bradleyeckert/chad/doc/README.md

# Feature summaries

- `crypto` SPI Flash encryption
- `debug` Debugging tools
- `forth` Differences from ANS Forth
- `interrupts` How interrupts work
- `io` I/O mapping
- `isa` Instruction Set Architecture
- `lcd` LCD module (ILI9341) simulator
- `manifesto` Ramblings of a madman
- `spif` SPI flash controller intelligent hub
