bradleyeckert/chad/utility/README.md

# Utilities

- `isp` an In-System-Programming over UART tool.
- `term` is a simple terminal using the same RS232 stack.
- `fonts` is a Unicode bitmap extraction tool for LCDs.

To Do:

Integrate `isp` into `term` to allow firmware updates without leaving the terminal.
