bradleyeckert/chad/doc/stack.png

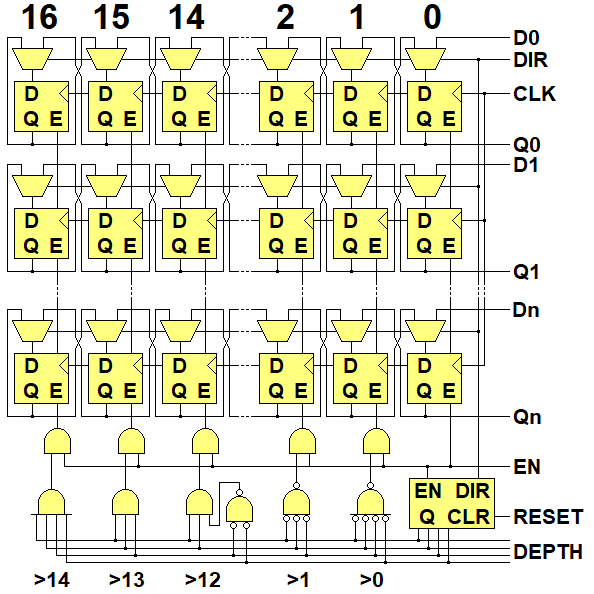
doc/stack.png
