bradleyeckert/chad/verilog/testbench/s25fl064l.v

///////////////////////////////////////////////////////////////////////////////
//  File name : s25fl064l.v
///////////////////////////////////////////////////////////////////////////////
//  Copyright (C) 2018-2019 Free Model Foundry; http://www.FreeModelFoundry.com
//
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
//  MODIFICATION HISTORY :
//
//  version: |   author:     |  mod date:  |  changes made:
//    V1.0      B.Barac        18 Feb 14     Initial version
//    V1.1      M.Dinic        18 Jun 08     Bug 18 fixed -
//                                           added !CSNeg condition for
//                                           two model instances
//    V1.2      B.Barac        19 Feb 06     SFDP update
//              B.Eckert       12 Oct 20     tdevice_PU = 3 ns
//
///////////////////////////////////////////////////////////////////////////////
//  PART DESCRIPTION:
//
//  Library:    FLASH
//  Technology: FLASH MEMORY
//  Part:       S25FL064L
//
//  Description: 64 Megabit Serial Flash Memory
//
//////////////////////////////////////////////////////////////////////////////
//  Comments :
//      For correct simulation, simulator resolution should be set to 1 ps
//
//////////////////////////////////////////////////////////////////////////////
//  Known Bugs:
//
//////////////////////////////////////////////////////////////////////////////

//////////////////////////////////////////////////////////////////////////////
// MODULE DECLARATION                                                       //
//////////////////////////////////////////////////////////////////////////////
`timescale 1 ps/1 ps

module s25fl064l
    (
        // Data Inputs/Outputs
        SI     ,
        SO     ,
        SCK    ,
        CSNeg  ,
        RESETNeg,
        WPNeg  ,
        IO3_RESETNeg
    );

///////////////////////////////////////////////////////////////////////////////
// Port / Part Pin Declarations
///////////////////////////////////////////////////////////////////////////////

    inout   SI            ;
    inout   SO            ;

    input   SCK           ;
    input   CSNeg         ;
    input   RESETNeg      ;
    inout   WPNeg         ;
    inout   IO3_RESETNeg  ;

    // interconnect path delay signals
    wire   SCK_ipd        ;
    wire   SI_ipd         ;
    wire   SO_ipd         ;
    wire   CSNeg_ipd      ;
    wire   RESETNeg_ipd   ;
    wire   WPNeg_ipd      ;
    wire   IO3_RESETNeg_ipd   ;

    wire SI_in            ;
    assign SI_in = SI_ipd ;

    wire SI_out           ;
    assign SI_out = SI    ;

    wire SO_in            ;
    assign SO_in = SO_ipd ;

    wire SO_out           ;
    assign SO_out = SO    ;

    wire   WPNeg_in                 ;
    //Internal pull-up
    assign WPNeg_in = (WPNeg_ipd === 1'bx) ? 1'b1 : WPNeg_ipd;

    wire   WPNeg_out                ;
    assign WPNeg_out = WPNeg        ;

    wire   RESETNeg_in              ;
    //Internal pull-up
    assign RESETNeg_in = (RESETNeg_ipd===1'bx) ? 1'b1:RESETNeg_ipd;

    wire   RESETNeg_out             ;
    assign RESETNeg_out = RESETNeg  ;

    wire   IO3_RESETNeg_in              ;
    //Internal pull-up
    assign IO3_RESETNeg_in=(IO3_RESETNeg_ipd===1'bx) ? 1'b1:IO3_RESETNeg_ipd;

    wire   IO3_RESETNeg_out             ;
    assign IO3_RESETNeg_out = IO3_RESETNeg  ;

    // internal delays
    reg ERSSUSP_in = 1'b0 ;
    reg ERSSUSP_out = 1'b0 ;
    reg PRGSUSP_in = 1'b0  ;
    reg PRGSUSP_out = 1'b0 ;
    reg PASSULCK_in = 1'b0 ;
    reg PASSULCK_out = 1'b0;
    reg SFT_RST_in = 1'b0;
    reg SFT_RST_out = 1'b1;
    reg HW_RST_in   = 1'b0;
    reg HW_RST_out  = 1'b1;
    reg DPD_in = 1'b0;
    reg DPD_out = 1'b0;
    reg RES_in = 1'b0;
    reg RES_out = 1'b0;
    reg QEN_in = 1'b0;
    reg QEN_out = 1'b0;
    reg QEXN_in = 1'b0;
    reg QEXN_out = 1'b0;

    reg rising_edge_CSNeg_ipd  = 1'b0;
    reg rising_edge_CSNeg_d    = 1'b0;
    reg falling_edge_CSNeg_ipd = 1'b0;
    reg rising_edge_SCK_ipd    = 1'b0;
    reg rising_edge_SCK_D      = 1'b0;
    reg falling_edge_SCK_D     = 1'b0;
    reg falling_edge_SCK_ipd   = 1'b0;
    reg falling_edge_RST       = 1'b0;
    reg rising_edge_PSTART     = 1'b0;
    reg rising_edge_PDONE      = 1'b0;
    reg rising_edge_ESTART     = 1'b0;
    reg rising_edge_EDONE      = 1'b0;
    reg rising_edge_WSTART_NV  = 1'b0;
    reg rising_edge_WSTART_V   = 1'b0;
    reg rising_edge_WDONE      = 1'b0;

    reg rising_edge_RES_out    = 1'b0;
    reg falling_edge_RES_in    = 1'b0;
    reg rising_edge_PRGSUSP_out;
    reg rising_edge_ERSSUSP_out;
    reg rising_edge_QEN_out;
    reg rising_edge_QEXN_out;
    reg rising_edge_PASSULCK_out;
    reg rising_edge_SFT_RST_out;
    reg rising_edge_HW_RST_out;
    reg rising_edge_reseted  = 1'b0;
    reg rising_edge_PoweredUp = 1'b0;

    reg SOut_zd        = 1'bZ;
    reg SIOut_zd       = 1'bZ;
    reg WPNegOut_zd    = 1'bZ;
    reg IO3_RESETNegOut_zd = 1'bZ;

    parameter UserPreload       = 1;
    parameter mem_file_name     = "none";//"s25fl064l.mem";
    parameter secr_file_name    = "s25fl064lSECR.mem";//"none";

    parameter TimingModel       = "DefaultTimingModel";

    parameter  PartID           = "s25fl064l";
    parameter  MaxData          = 255;
    parameter  MemSize          = 24'h7FFFFF;
    parameter  PageSize         = 8'hFF;
    parameter  SecRegSize       = 8'hFF;
    parameter  SecSize          = 12'hFFF;
    parameter  HalfBlockSize    = 15'h7FFF;
    parameter  BlockSize        = 16'hFFFF;
    parameter  SecNum           = 12'h7FF;
    parameter  BlockNum         = 7'h7F;
    parameter  HalfBlockNum     = 8'hFF;
    parameter  SecRegNum        = 3;

    parameter  PageNum          = 19'h7FFF;
    parameter  AddrRANGE        = 27'h7FFFFF;

    parameter  SECRLoAddr       = 12'h000;
    parameter  SECRHiAddr       = 12'h3FF;

    parameter  SFDPLoAddr       = 16'h0000;
    parameter  SFDPHiAddr       = 16'h5FF;
    parameter  SFDPLength       = 16'h5FF;

    parameter  IDCFILength      = 16'h115;

    parameter  ManufIDDeviceID  = 24'h176001;
    parameter  DeviceID         = 16'h6017;
    parameter  UID              = 64'b0;

    reg SECURE_OPN = 1'b0;
    reg QIO_ONLY_OPN = 1'b0;
    reg QPI_ONLY_OPN = 1'b0;

    reg [24*8-1:0] tmp_timing;//stores copy of TimingModel
    reg [7:0] tmp_char1; //Define General Market or Secure Device
    integer found = 1'b0;

    // If speedsimulation is needed uncomment following line

//        `define SPEEDSIM;

    // powerup
    reg PoweredUp;

    // FSM states
    parameter STANDBY             = 7'd0;
    parameter RESET_STATE         = 7'd1;
    parameter RD_ADDR             = 7'd2;
    parameter FAST_RD_ADDR        = 7'd3;
    parameter DUALO_RD_ADDR       = 7'd4;
    parameter DUALIO_RD_ADDR      = 7'd5;
    parameter QUADO_RD_ADDR       = 7'd6;
    parameter QUADIO_RD_ADDR      = 7'd7;
    parameter DDRQUADIO_RD_ADDR   = 7'd8;
    parameter DLPRD_DUMMY         = 7'd9;
    parameter IRPRD_DUMMY         = 7'd10;
    parameter IBLRD_ADDR          = 7'd11;
    parameter SFT_RST_EN          = 7'd12;
    parameter SECRR_ADDR          = 7'd13;
    parameter PASSRD_DUMMY        = 7'd14;
    parameter PRRD_DUMMY          = 7'd15;
    parameter RDID_DATA_OUTPUT    = 7'd16;
    parameter RDQID_DATA_OUTPUT   = 7'd17;
    parameter RUID_DUMMY          = 7'd18;
    parameter RSFDP_ADDR          = 7'd19;
    parameter SET_BURST_DATA_INPUT = 7'd20;
    parameter RDSR1_DATA_OUTPUT    = 7'd21;
    parameter RDSR2_DATA_OUTPUT    = 7'd22;
    parameter RDCR1_DATA_OUTPUT    = 7'd23;
    parameter RDCR2_DATA_OUTPUT    = 7'd24;
    parameter RDCR3_DATA_OUTPUT    = 7'd25;
    parameter RDAR_ADDR            = 7'd26;
    parameter DPD                  = 7'd27;
    parameter RDP_DUMMY            = 7'd28;
    parameter PGM_ADDR             = 7'd29;
    parameter SECT_ERS_ADDR        = 7'd30;
    parameter HALF_BLOCK_ERS_ADDR  = 7'd31;
    parameter BLOCK_ERS_ADDR       = 7'd32;
    parameter CHIP_ERS             = 7'd33;
    parameter IBL_LOCK             = 7'd34;
    parameter IRP_PGM_DATA_INPUT   = 7'd35;
    parameter WRR_DATA_INPUT       = 7'd36;
    parameter WRAR_ADDR            = 7'd37;
    parameter PASSP_DATA_INPUT     = 7'd38;
    parameter SEC_REG_PGM_ADDR     = 7'd39;
    parameter SEC_REG_ERS_ADDR     = 7'd40;
    parameter PASSU_DATA_INPUT     = 7'd41;
    parameter IBL_UNLOCK           = 7'd42;
    parameter SET_PNTR_PROT_ADDR   = 7'd43;
    parameter PGM_NV_DLR_DATA      = 7'd44;
    parameter DLRV_WRITE_DATA      = 7'd45;
    parameter RD_DATA              = 7'd46;
    parameter FAST_RD_DUMMY        = 7'd47;
    parameter FAST_RD_DATA         = 7'd48;
    parameter DUALO_RD_DUMMY       = 7'd49;
    parameter DUALO_RD_DATA        = 7'd50;
    parameter QUADO_RD_DUMMY       = 7'd51;
    parameter QUADO_RD_DATA        = 7'd52;
    parameter DUALIO_RD_DUMMY      = 7'd53;
    parameter DUALIO_RD_MODE       = 7'd54;
    parameter DUALIO_RD_DATA       = 7'd55;
    parameter QUADIO_RD_DUMMY      = 7'd56;
    parameter QUADIO_RD_MODE       = 7'd57;
    parameter QUADIO_RD_DATA       = 7'd58;
    parameter DDRQUADIO_RD_DUMMY   = 7'd59;
    parameter DDRQUADIO_RD_MODE    = 7'd60;
    parameter DDRQUADIO_RD_DATA    = 7'd61;
    parameter RDAR_DUMMY           = 7'd62;
    parameter RDAR_DATA_OUTPUT     = 7'd63;
    parameter PGM_DATAIN           = 7'd64;
    parameter PGM                  = 7'd65;
    parameter PGMSUS               = 7'd66;
    parameter SECT_ERS             = 7'd67;
    parameter HALF_BLOCK_ERS       = 7'd68;
    parameter BLOCK_ERS            = 7'd69;
    parameter ERSSUS               = 7'd70;
    parameter SEC_REG_PGM_DATAIN   = 7'd71;
    parameter PGM_SEC_REG          = 7'd72;
    parameter SECT_ERS_SEC_REG     = 7'd73;
    parameter DLPRD_DATA_OUTPUT    = 7'd74;
    parameter IRPRD_DATA_OUTPUT    = 7'd75;
    parameter IBLRD_DATA_OUTPUT    = 7'd76;
    parameter SECRR_DUMMY          = 7'd77;
    parameter SECRR_DATA_OUTPUT    = 7'd78;
    parameter PASSRD_DATA_OUTPUT   = 7'd79;
    parameter PRRD_DATA_OUTPUT     = 7'd80;
    parameter RUID_DATA_OUTPUT     = 7'd81;
    parameter RSFDP_DUMMY          = 7'd82;
    parameter RSFDP_DATA_OUTPUT    = 7'd83;
    parameter RDP_DATA_OUTPUT      = 7'd84;
    parameter IRP_PGM              = 7'd85;
    parameter WRR_NV               = 7'd86;
    parameter WRR_V                = 7'd87;
    parameter WRAR_DATA_INPUT      = 7'd88;
    parameter WRAR_NV              = 7'd89;
    parameter WRAR_V               = 7'd90;
    parameter PGM_NV_DLR           = 7'd91;
    parameter SET_PNTR_PROT        = 7'd92;
    parameter PASS_PGM             = 7'd93;
    parameter PASS_ULCK            = 7'd94;

    reg [6:0] current_state = STANDBY;
    reg [6:0] next_state = STANDBY;

    // Instruction type
    parameter NONE            = 7'd0;
    parameter READ            = 7'd1;
    parameter READ4           = 7'd2;
    parameter FAST_READ       = 7'd3;
    parameter FAST_READ4      = 7'd4;
    parameter DOR             = 7'd5;
    parameter DOR4            = 7'd6;
    parameter DIOR            = 7'd7;
    parameter DIOR4           = 7'd8;
    parameter QOR             = 7'd9;
    parameter QOR4            = 7'd10;
    parameter QIOR            = 7'd11;
    parameter QIOR4           = 7'd12;
    parameter DDRQIOR         = 7'd13;
    parameter DDRQIOR4        = 7'd14;
    parameter DLPRD           = 7'd15;
    parameter IRPRD           = 7'd16;
    parameter IBLRD           = 7'd17;
    parameter IBLRD4          = 7'd18;
    parameter RSTEN           = 7'd19;
    parameter SECRR           = 7'd20;
    parameter PASSRD          = 7'd21;
    parameter PRRD            = 7'd22;
    parameter RDID            = 7'd23;
    parameter RDQID           = 7'd24;
    parameter RUID            = 7'd25;
    parameter RSFDP           = 7'd26;
    parameter SET_BURST       = 7'd27;
    parameter BEN4            = 7'd28;
    parameter BEX4            = 7'd29;
    parameter QPIEN           = 7'd30;
    parameter QPIEX           = 7'd31;
    parameter RDSR1           = 7'd32;
    parameter RDSR2           = 7'd33;
    parameter RDCR1           = 7'd34;
    parameter RDCR2           = 7'd35;
    parameter RDCR3           = 7'd36;
    parameter RDAR            = 7'd37;
    parameter DEEP_PD         = 7'd38;
    parameter RES             = 7'd39;
    parameter WREN            = 7'd40;
    parameter WRENV           = 7'd41;
    parameter WRDI            = 7'd42;
    parameter CLSR            = 7'd43;
    parameter PP              = 7'd44;
    parameter PP4             = 7'd45;
    parameter QPP             = 7'd46;
    parameter QPP4            = 7'd47;
    parameter SE              = 7'd48;
    parameter SE4             = 7'd49;
    parameter HBE             = 7'd50;
    parameter HBE4            = 7'd51;
    parameter BE              = 7'd52;
    parameter BE4             = 7'd53;
    parameter CE              = 7'd54;
    parameter IBL             = 7'd55;
    parameter IBL4            = 7'd56;
    parameter IRPP            = 7'd57;
    parameter WRR             = 7'd58;
    parameter WRAR            = 7'd59;
    parameter PASSP           = 7'd60;
    parameter SECRP           = 7'd61;
    parameter SECRE           = 7'd62;
    parameter PASSU           = 7'd63;
    parameter PRL             = 7'd64;
    parameter IBUL            = 7'd65;
    parameter IBUL4           = 7'd66;
    parameter GBL             = 7'd67;
    parameter GBUL            = 7'd68;
    parameter SPRP            = 7'd69;
    parameter SPRP4           = 7'd70;
    parameter PDLRNV          = 7'd71;
    parameter WDLRV           = 7'd72;
    parameter EPS             = 7'd73;
    parameter EPR             = 7'd74;
    parameter RSTCMD          = 7'd75;

    // Command Register
    reg [7:0] Instruct;
    reg [7:0] Instruct_tmp;
    reg [7:0] mode_byte;

    reg reseted;
    reg RST = 1;

    reg WREN_V;
    integer opcode_cnt = 0;
    reg [7:0] opcode;
    reg [31:0] Address;
    reg [31:0] Address_wrar;
    integer sec;
    integer blk;
    integer pgm_page;
    integer sec_region;
    integer addr_cnt = 0;
    integer Latency_code;
    integer WrapLength;
    integer dummy_cnt = 0;
    integer mode_cnt = 0;
    integer read_cnt  = 0;
    integer byte_cnt  = 0;
    reg[7:0] data_out;

    integer data_cnt   = 0;
    integer bit_cnt    = 0;
    reg[7:0] Data_in[0:PageSize];
    reg [7:0] Byte_slv = {8{1'b1}};

    integer WByte[0:255];
    integer WData [0:255];

    integer Addr;
    integer Addr_tmp;

    reg [SecNum:0] Sec_Prot = {(SecNum+1){1'b0}};
    reg [HalfBlockNum:0] HalfBlock_Prot = {(HalfBlockNum+1){1'b0}};
    reg [BlockNum:0] Block_Prot = {(BlockNum+1){1'b0}};

    reg [SecNum:0] Legacy_Sec_Prot  = {(SecNum+1){1'b0}};
    reg [SecNum:0] IBL_Sec_Prot  = {(SecNum+1){1'b0}};
    reg [SecNum:0] PRP_Sec_Prot  = {(SecNum+1){1'b0}};

    reg DPD_ACT;
    reg DLP_ACT;
    reg PGM_ACT = 0;
    reg PGM_SEC_REG_ACT = 0;
    reg SECT_ERS_ACT = 0;
    reg HALF_BLOCK_ERS_ACT = 0;
    reg BLOCK_ERS_ACT = 0;
    reg CHIP_ERS_ACT = 0;
    reg SECT_ERS_SEC_REG_ACT = 0;
    reg WRR_NV_ACT = 0;
    reg WRAR_NV_ACT = 0;
    reg IRP_ACT = 0;
    reg DLRNV_ACT = 0;
    reg SET_PNTR_PROT_ACT = 0;
    reg PASS_PGM_ACT = 0;

    reg DLRNV_programmed = 0;

    time CLK_PER;
    time LAST_CLK;

    // FSM control signals
    reg PDONE     ;
    reg PSTART    ;
    reg PGSUSP    ;
    reg PGRES     ;

    reg RES_TO_SUSP_TIME;

    reg WDONE     ;
    reg WSTART_NV ;
    reg WSTART_V  ;

    reg EDONE     ;
    reg ESTART    ;
    reg ESUSP     ;
    reg ERES      ;

    reg WL6       ;
    reg WL5       ;
    reg WL4       ;

    // SFDP array
    integer SFDP_array[SFDPLoAddr:SFDPHiAddr];
    // Security Region array
    integer SECRMem[SECRLoAddr:SECRHiAddr];
    // Flash Memory Array
    integer Mem[0:AddrRANGE];

    //-----------------------------------------
    //  Registers
    //-----------------------------------------

    reg [7:0] SR1NV    = 8'h00;
    reg [7:0] SR1V     = 8'h00;
    reg [7:0] SR1_in   = 8'h00;

    wire SEC;
    assign SEC = SR1V[6];
    wire TBPROT;
    assign TBPROT = SR1V[5];
    wire BP2;
    assign BP2 = SR1V[4];
    wire BP1;
    assign BP1 = SR1V[3];
    wire BP0;
    assign BP0 = SR1V[2];
    wire WEL;
    assign WEL = SR1V[1];
    wire WIP;
    assign WIP = SR1V[0];

    reg [7:0] SR2V     = 8'h00;

    reg [7:0] CR1NV    = 8'h00;
    reg [7:0] CR1V     = 8'h00;
    reg [7:0] CR1_in   = 8'h00;

    wire CMP;
    assign CMP = CR1V[6];
    wire LB3;
    assign LB3 = CR1V[5];
    wire LB2;
    assign LB2 = CR1V[4];
    wire LB1;
    assign LB1 = CR1V[3];
    wire LB0;
    assign LB0 = CR1V[2];
    wire QUAD;
    assign QUAD = CR1V[1];
    wire srp1;
    assign srp1 = CR1V[0];

    reg [7:0] CR2NV    = 8'h60;
    reg [7:0] CR2V     = 8'h60;
    reg [7:0] CR2_in   = 8'h00;

    wire QPI;
    assign QPI = CR2V[3];
    wire IO3R;
    assign IO3R = CR2V[7];
    wire WPS;
    assign WPS = CR2V[2];

    reg [7:0] CR3NV    = 8'h78;
    reg [7:0] CR3V     = 8'h78;
    reg [7:0] CR3_in   = 8'h00;

    reg [31:0] WRR_in  = 32'd0;
    reg [7:0] WRAR_in  = 8'd0;

    reg[15:0] IRP    = 16'hFFFD;
    reg[15:0] IRP_in = 16'hFFFD;

    reg[63:0] Password_reg     = 64'hFFFFFFFFFFFFFFFF;
    reg[63:0] Password_reg_in  = 64'hFFFFFFFFFFFFFFFF;
    reg[63:0] Password_regU_in = 64'h0;

    // Protection Register
    reg[7:0] PR              = 8'h41;
    reg[7:0] PR_in           = 8'h41;

    wire   NVLOCK;
    assign NVLOCK     = PR[0];
    wire   SECRRP;
    assign SECRRP     = PR[6];

    // Pointer Region Protect Register
    reg[31:0] PRPR    = 32'hFFFFFFFF;
    reg[31:0] PRPR_in  = 32'hFFFFFFFF;

    // Individual Block Lock Access Register
    reg[7:0] IBLAR             = 8'h00;

    // DLP registers
    reg[7:0] DLRV          = 8'h00;
    reg[7:0] DLRNV         = 8'h00;
    reg[7:0] DLRV_in       = 8'h00;
    reg[7:0] DLRNV_in      = 8'h00;

    reg [7:0] RDAR_reg    = 8'h00;

    integer SectorErase = 0;
    integer HalfBlockErase = 0;
    integer BlockErase = 0;

    // timing check violation
    reg Viol = 1'b0;

    integer AddrLOW;
    integer AddrHIGH;

    reg[7:0]  old_bit, new_bit;
    integer old_int, new_int;
    integer wr_cnt;
    integer cnt;

    reg normal_rd = 0;
    reg fast_rd = 1;
    reg ddr_rd = 0;
    reg reg_rd = 0;

    reg frst_addr_nibb;

    reg  glitch = 1'b0;
    reg  DataDriveOut_SO = 1'bZ ;
    reg  DataDriveOut_SI = 1'bZ ;
    reg  DataDriveOut_IO3_RESET = 1'bZ ;
    reg  DataDriveOut_WP = 1'bZ ;

///////////////////////////////////////////////////////////////////////////////
//Interconnect Path Delay Section
///////////////////////////////////////////////////////////////////////////////
 buf   (SCK_ipd, SCK);
 buf   (SI_ipd, SI);
 buf   (SO_ipd, SO);
 buf   (CSNeg_ipd, CSNeg);
 buf   (WPNeg_ipd, WPNeg);
 buf   (IO3_RESETNeg_ipd, IO3_RESETNeg);

///////////////////////////////////////////////////////////////////////////////
// Propagation  delay Section
///////////////////////////////////////////////////////////////////////////////
    nmos   (SI,       SIOut_zd       , 1);
    nmos   (SO,       SOut_zd        , 1);
    nmos   (IO3_RESETNeg, IO3_RESETNegOut_zd , 1);
    nmos   (WPNeg,    WPNegOut_zd    , 1);

    // Needed for TimingChecks
    // VHDL CheckEnable Equivalent

    wire io3_rst;
    assign io3_rst = IO3R && ((~QUAD & ~QPI) | CSNeg_ipd);

    wire ddr;
    assign ddr = (Instruct==DDRQIOR) | (Instruct==DDRQIOR4);

    wire RST_QUAD;
    assign RST_QUAD = IO3R & (QUAD | QPI);

    wire datain;
    assign datain = SOut_zd === 1'bz;

    wire datain_ddr;
    assign datain_ddr = datain & ddr;

    wire srp0;
    assign srp0 = SR1V[7];

    wire WrProt;
    assign WrProt = SR1V[7] & ~CR1V[1] & ~CR2V[3];

    wire rd_normal;
    wire rd_fast;
    wire rd_ddr;
    wire rd_reg;

    assign rd_normal = normal_rd;
    assign rd_fast = fast_rd;
    assign rd_ddr = ddr_rd;
    assign rd_reg = reg_rd;

specify
        // tipd delays: interconnect path delays , mapped to input port delays.
        // In Verilog is not necessary to declare any tipd_ delay variables,
        // they can be taken from SDF file
        // With all the other delays real delays would be taken from SDF file

    // tpd delays
    specparam        tpd_SCK_SO      = 1; // tV
    specparam        tpd_CSNeg_SO_RST_QUAD_EQ_1 = 1; // tDIS
    specparam        tpd_CSNeg_SO_RST_QUAD_EQ_0 = 1; // tDIS

    //tsetup values: setup times
    specparam        tsetup_CSNeg_SCK        = 1;   // tCSS edge /
    specparam        tsetup_SI_SCK           = 1;   // tSU  edge /
    specparam        tsetup_WPNeg_CSNeg      = 1;   // tWPS edge \

    //thold values: hold times
    specparam        thold_CSNeg_SCK         = 1;   // tCSH edge /
    specparam        thold_SI_SCK            = 1;   // tHD  edge /
    specparam        thold_WPNeg_CSNeg       = 1;   // tWPH edge /
    specparam        thold_CSNeg_RESETNeg    = 1;   // tRH  edge /
    specparam        thold_CSNeg_IO3_RESETNeg= 1;   // tRH  edge /

    // tpw values: pulse width
    specparam        tpw_SCK_normal  = 1;
    specparam        tpw_SCK_fast    = 1;
    specparam        tpw_SCK_ddr     = 1;
    specparam        tpw_SCK_reg     = 1;
    specparam        tpw_CSNeg       = 1;   // tCS
    specparam        tpw_RESETNeg    = 1;   // tRP
    specparam        tpw_IO3_RESETNeg= 1;   // tRP

    // tperiod min (calculated as 1/max freq)
    specparam        tperiod_SCK_normal   = 1;   // 50 MHz
    specparam        tperiod_SCK_fast     = 1;   //108 MHz
    specparam        tperiod_SCK_ddr      = 1;   // 54 MHz
    specparam        tperiod_SCK_reg      = 1;   // 108 MHz

    `ifdef SPEEDSIM
        // WRR Cycle Time
        specparam        tdevice_WRR               = 1200e9; //tW = 1200us
        // Page Program Operation
        specparam        tdevice_PP                = 1350e6; //tPP = 1350us
        // Byte Programming
        specparam        tdevice_BP1               = 90e6; //tBP1 = 90us
        // Byte Programming
        specparam        tdevice_BP2               = 30e6; //tBP2 = 30us
        // 4 KB Sector Erase Operation
        specparam        tdevice_SE                = 320e6; //tSE = 320us
        // 32 KB Half Block Erase Operation
        specparam        tdevice_HBE               = 600e6; //tHBE = 600us
       // 64 KB Block Erase Operation
        specparam        tdevice_BE                = 1150e6; //tBE = 1150us
        // Chip Erase Operation
        specparam        tdevice_CE                = 150e9; //tCE = 150ms
        // Suspend Latency
        specparam        tdevice_SUSP              = 40e6; //tSL = 40us
        // Resume to next Suspend Time
        specparam        tdevice_RNS               = 100e6;//tRS = 100 us
        // RESET# Low to CS# Low
        specparam        tdevice_RPH               = 100e6; //tRPH = 100 us
        // VCC (min) to CS# Low
        specparam        tdevice_PU                = 300e1;//tPU = 300us
        // Password Unlock to Password Unlock Time
        specparam        tdevice_PASSACC           = 100e6;// 100us
        // DPD enter
        specparam        tdevice_DPD               = 3e6;// 3us
        // Release DPD
        specparam        tdevice_RES               = 5e6;// 5us
        // QIO, QPI mode enter to the next command
        specparam        tdevice_QEN               = 1.5e6;// 1.5us
        // QIO, QPI mode exit to the next command
        specparam        tdevice_QEXN              = 1e6;// 1us
        // Volatile registers write time
        specparam        tdevice_CS                = 50e3; //tCS = 50ns
    `else
        // WRR Cycle Time
        specparam        tdevice_WRR               = 1200e9; //tW = 1200ms
        // Page Program Operation
        specparam        tdevice_PP                = 1350e6; //tPP = 1350us
        // Byte Programming
        specparam        tdevice_BP1               = 90e6; //tBP1 = 90us
        // Byte Programming
        specparam        tdevice_BP2               = 30e6; //tBP2 = 30us
        // 4 KB Sector Erase Operation
        specparam        tdevice_SE                = 320e9; //tSE = 320ms
        // 32 KB Half Block Erase Operation
        specparam        tdevice_HBE               = 600e9; //tHBE = 600ms
       // 64 KB Block Erase Operation
        specparam        tdevice_BE                = 1150e9; //tBE = 1150ms
        // Chip Erase Operation
        specparam        tdevice_CE                = 150e12; //tCE = 150s
        // Suspend Latency
        specparam        tdevice_SUSP              = 40e6; //tSL = 40us
        // Resume to next Suspend Time
        specparam        tdevice_RNS               = 100e6;//tRS = 100 us
        // RESET# Low to CS# Low
        specparam        tdevice_RPH               = 100e6; //tRPH = 100 us
        // VCC (min) to CS# Low
        specparam        tdevice_PU                = 300e1;//tPU = 300us
        // Password Unlock to Password Unlock Time
        specparam        tdevice_PASSACC           = 100e6;// 100us
        // DPD enter
        specparam        tdevice_DPD               = 3e6;// 3us
        // Release DPD
        specparam        tdevice_RES               = 5e6;// 5us
        // QIO, QPI mode enter to the next command
        specparam        tdevice_QEN               = 1.5e6;// 1.5us
        // QIO, QPI mode exit to the next command
        specparam        tdevice_QEXN              = 1e6;// 1us
        // Volatile registers write time
        specparam        tdevice_CS                = 50e3; //tCS = 50ns

    `endif // SPEEDSIM

///////////////////////////////////////////////////////////////////////////////
// Input Port  Delays  don't require Verilog description
///////////////////////////////////////////////////////////////////////////////
// Path delays                                                               //
///////////////////////////////////////////////////////////////////////////////
   if (~glitch)     (SCK => SO) = tpd_SCK_SO;
   if (~glitch)     (SCK => SI) = tpd_SCK_SO;
   if (~glitch)     (SCK => IO3_RESETNeg) = tpd_SCK_SO;
   if (~glitch)     (SCK => WPNeg)        = tpd_SCK_SO;

   if (RST_QUAD)    (CSNeg => SO)  = tpd_CSNeg_SO_RST_QUAD_EQ_1;
   if (RST_QUAD)    (CSNeg => SI)  = tpd_CSNeg_SO_RST_QUAD_EQ_1;
   if (RST_QUAD)    (CSNeg => IO3_RESETNeg) = tpd_CSNeg_SO_RST_QUAD_EQ_1;
   if (RST_QUAD)    (CSNeg => WPNeg)        = tpd_CSNeg_SO_RST_QUAD_EQ_1;

   if (~RST_QUAD)   (CSNeg => SO)  = tpd_CSNeg_SO_RST_QUAD_EQ_0;
   if (~RST_QUAD)   (CSNeg => SI)  = tpd_CSNeg_SO_RST_QUAD_EQ_0;
   if (~RST_QUAD)   (CSNeg => IO3_RESETNeg) = tpd_CSNeg_SO_RST_QUAD_EQ_0;
   if (~RST_QUAD)   (CSNeg => WPNeg)        = tpd_CSNeg_SO_RST_QUAD_EQ_0;

///////////////////////////////////////////////////////////////////////////////
// Timing Violation                                                          //
///////////////////////////////////////////////////////////////////////////////
    $setup ( CSNeg  , posedge SCK,                    tsetup_CSNeg_SCK , Viol);

    $setup ( SI     , posedge SCK &&& datain,            tsetup_SI_SCK , Viol);
    $setup ( SI     , negedge SCK &&& datain_ddr,        tsetup_SI_SCK , Viol);
    $setup ( SO     , posedge SCK &&& datain,            tsetup_SI_SCK , Viol);
    $setup ( SO     , negedge SCK &&& datain_ddr,        tsetup_SI_SCK , Viol);
    $setup ( IO3_RESETNeg  , posedge SCK &&& datain,     tsetup_SI_SCK , Viol);
    $setup ( IO3_RESETNeg  , negedge SCK &&& datain_ddr, tsetup_SI_SCK , Viol);
    $setup ( WPNeg  , posedge SCK &&& datain,            tsetup_SI_SCK , Viol);
    $setup ( WPNeg  , negedge SCK &&& datain_ddr,        tsetup_SI_SCK , Viol);

    $setup ( WPNeg  , negedge CSNeg &&& WrProt,        tsetup_WPNeg_CSNeg , Viol);

    $hold  ( posedge SCK    , CSNeg,                 thold_CSNeg_SCK    , Viol);

    $hold  ( posedge SCK &&& datain,     SI ,             thold_SI_SCK    ,Viol);
    $hold  ( negedge SCK &&& datain_ddr, SI ,             thold_SI_SCK    ,Viol);
    $hold  ( posedge SCK &&& datain,     SO ,             thold_SI_SCK    ,Viol);
    $hold  ( negedge SCK &&& datain_ddr, SO ,             thold_SI_SCK    ,Viol);
    $hold  ( posedge SCK &&& datain,     IO3_RESETNeg,    thold_SI_SCK    ,Viol);
    $hold  ( negedge SCK &&& datain_ddr, IO3_RESETNeg,    thold_SI_SCK    ,Viol);
    $hold  ( posedge SCK &&& datain,     WPNeg,           thold_SI_SCK    ,Viol);
    $hold  ( negedge SCK &&& datain_ddr, WPNeg,           thold_SI_SCK    ,Viol);

    $hold  ( posedge CSNeg &&& WrProt,  WPNeg,        thold_WPNeg_CSNeg   ,Viol);
    $hold  ( posedge RESETNeg,        negedge CSNeg, thold_CSNeg_RESETNeg,Viol);
    $hold  ( posedge IO3_RESETNeg &&& IO3R, negedge CSNeg, thold_CSNeg_IO3_RESETNeg,Viol);

    $width ( posedge SCK &&& rd_normal           , tpw_SCK_normal);
    $width ( negedge SCK &&& rd_normal           , tpw_SCK_normal);
    $width ( posedge SCK &&& rd_fast             , tpw_SCK_fast);
    $width ( negedge SCK &&& rd_fast             , tpw_SCK_fast);
    $width ( posedge SCK &&& rd_ddr              , tpw_SCK_ddr);
    $width ( negedge SCK &&& rd_ddr              , tpw_SCK_ddr);
    $width ( posedge SCK &&& rd_reg              , tpw_SCK_reg);
    $width ( negedge SCK &&& rd_reg              , tpw_SCK_reg);

    $width ( posedge CSNeg                       , tpw_CSNeg);
    $width ( negedge RESETNeg                    , tpw_RESETNeg);
    $width ( negedge IO3_RESETNeg &&& io3_rst    , tpw_IO3_RESETNeg);

    $period ( posedge SCK &&& rd_normal          , tperiod_SCK_normal);
    $period ( posedge SCK &&& rd_fast            , tperiod_SCK_fast);
    $period ( posedge SCK &&& rd_ddr             , tperiod_SCK_ddr);
    $period ( posedge SCK &&& rd_reg             , tperiod_SCK_reg);

endspecify

///////////////////////////////////////////////////////////////////////////////
// Main Behavior Block                                                       //
///////////////////////////////////////////////////////////////////////////////

    //Power Up time;
    initial
    begin
        PoweredUp = 1'b0;
        #tdevice_PU PoweredUp = 1'b1;
    end

    initial
    begin : Init
        Address     = 0;
        Address_wrar= 0;
        RST         = 1'b1;
        SFT_RST_out = 1'b1;
        HW_RST_out  = 1'b1;
        PDONE       = 1'b1;
        PSTART      = 1'b0;
        PGSUSP      = 1'b0;
        PGRES       = 1'b0;
        PRGSUSP_in  = 1'b0;
        ERSSUSP_in  = 1'b0;
        RES_TO_SUSP_TIME  = 1'b0;
        EDONE       = 1'b1;
        ESTART      = 1'b0;
        ESUSP       = 1'b0;
        ERES        = 1'b0;
        WDONE       = 1'b1;
        WSTART_NV   = 1'b0;
        WSTART_V    = 1'b0;
        reseted     = 1'b0;
        Instruct    = NONE;

        current_state   = STANDBY;
        next_state      = STANDBY;
    end

    // initialize memory and load preload files if any
    initial
    begin: InitMemory
        integer i;

        for (i=0;i<=AddrRANGE;i=i+1)
            Mem[i] = MaxData;


        if ((UserPreload) && !(mem_file_name == "none"))
        begin
           // Memory Preload
           //s25fl128l.mem, memory preload file
           //  @aaaaaaa - <aaaaaaa> stands for address
           //  dd       - <dd> is byte to be written at Mem(aaaaaaa++)
           // (aaaaaaa is incremented at every load)
           $readmemh(mem_file_name,Mem);
        end

        for (i=SECRLoAddr;i<=SECRHiAddr;i=i+1)
            SECRMem[i] = MaxData;

        if (UserPreload && !(secr_file_name == "none"))
        begin
        //s25fl128l_secr memory file
        //   /        - comment
        //   @aaa - <aaa> stands for address
        //   dd  - <dd> is byte to be written at OTPMem(aaa++)
        //   (aaa is incremented at every load)
        //   only first 1-4 columns are loaded. NO empty lines !!!!!!!!!!!!!!!!
           $readmemh(secr_file_name,SECRMem);
        end
    end

    initial
    begin: InitTimingModel
    integer i;
    integer j;
        tmp_timing = TimingModel;//copy of TimingModel

        i = 23;
        while ((i >= 0) && (found != 1'b1))//search for first non null character
        begin        //i keeps position of first non null character
            j = 7;
            while ((j >= 0) && (found != 1'b1))
            begin
                if (tmp_timing[i*8+j] != 1'd0)
                    found = 1'b1;
                else
                    j = j-1;
            end
            i = i - 1;
        end
        i = i +1;
        if (found)//if non null character is found
        begin
            for (j=0;j<=7;j=j+1)
            begin
            //Security character is 15
                tmp_char1[j] = TimingModel[(i-14)*8+j];
            end
        end

        if (tmp_char1 == "S" || tmp_char1 == "s")
        begin
            SECURE_OPN = 1'b1;
            IRP = 16'hFFFF;
        end
        else if (tmp_char1 == "4" )
        begin
            QIO_ONLY_OPN = 1'b1;
            CR1NV = 8'h02;
            CR1V = 8'h02;
        end
        else if (tmp_char1 == "P" || tmp_char1 == "p" )
        begin
            QPI_ONLY_OPN = 1'b1;
            CR2NV = 8'h68;
            CR2V = 8'h68;
        end
    end

    //SFDP
    initial
    begin: InitSFDP
    integer i;
        ///////////////////////////////////////////////////////////////////////
        // SFDP Header
        ///////////////////////////////////////////////////////////////////////
        SFDP_array[16'h0000] = 8'h53;
        SFDP_array[16'h0001] = 8'h46;
        SFDP_array[16'h0002] = 8'h44;
        SFDP_array[16'h0003] = 8'h50;
        SFDP_array[16'h0004] = 8'h06;
        SFDP_array[16'h0005] = 8'h01;
        SFDP_array[16'h0006] = 8'h01;
        SFDP_array[16'h0007] = 8'hFF;
        SFDP_array[16'h0008] = 8'h00;
        SFDP_array[16'h0009] = 8'h06;
        SFDP_array[16'h000A] = 8'h01;
        SFDP_array[16'h000B] = 8'h10;
        SFDP_array[16'h000C] = 8'h00;
        SFDP_array[16'h000D] = 8'h03;
        SFDP_array[16'h000E] = 8'h00;
        SFDP_array[16'h000F] = 8'hFF;
        SFDP_array[16'h0010] = 8'h84;
        SFDP_array[16'h0011] = 8'h00;
        SFDP_array[16'h0012] = 8'h01;
        SFDP_array[16'h0013] = 8'h02;
        SFDP_array[16'h0014] = 8'h40;
        SFDP_array[16'h0015] = 8'h03;
        SFDP_array[16'h0016] = 8'h00;
        SFDP_array[16'h0017] = 8'hFF;
        for (i=16'h0018; i<16'h02FF; i=i+1)
        begin
            SFDP_array[i] = 8'hFF; // undefined space
        end
        // Basic SPI Flash Parameter, JEDEC SFDP Rev B
        SFDP_array[16'h0300] = 8'hE5;
        SFDP_array[16'h0301] = 8'h20;
        SFDP_array[16'h0302] = 8'hFB;
        SFDP_array[16'h0303] = 8'hFF;
        SFDP_array[16'h0304] = 8'hFF;
        SFDP_array[16'h0305] = 8'hFF;
        SFDP_array[16'h0306] = 8'hFF;
        SFDP_array[16'h0307] = 8'h03;
        SFDP_array[16'h0308] = 8'h48;
        SFDP_array[16'h0309] = 8'hEB;
        SFDP_array[16'h030A] = 8'h08;
        SFDP_array[16'h030B] = 8'h6B;
        SFDP_array[16'h030C] = 8'h08;
        SFDP_array[16'h030D] = 8'h3B;
        SFDP_array[16'h030E] = 8'h88;
        SFDP_array[16'h030F] = 8'hBB;
        SFDP_array[16'h0310] = 8'hFE;
        SFDP_array[16'h0311] = 8'hFF;
        SFDP_array[16'h0312] = 8'hFF;
        SFDP_array[16'h0313] = 8'hFF;
        SFDP_array[16'h0314] = 8'hFF;
        SFDP_array[16'h0315] = 8'hFF;
        SFDP_array[16'h0316] = 8'hFF;
        SFDP_array[16'h0317] = 8'hFF;
        SFDP_array[16'h0318] = 8'hFF;
        SFDP_array[16'h0319] = 8'hFF;
        SFDP_array[16'h031A] = 8'h48;
        SFDP_array[16'h031B] = 8'hEB;
        SFDP_array[16'h031C] = 8'h0C;
        SFDP_array[16'h031D] = 8'h20;
        SFDP_array[16'h031E] = 8'h0F;
        SFDP_array[16'h031F] = 8'h52;
        SFDP_array[16'h0320] = 8'h10;
        SFDP_array[16'h0321] = 8'hD8;
        SFDP_array[16'h0322] = 8'h00;
        SFDP_array[16'h0323] = 8'hFF;
        SFDP_array[16'h0324] = 8'h31;
        SFDP_array[16'h0325] = 8'h92;
        SFDP_array[16'h0326] = 8'h0D; //
        SFDP_array[16'h0327] = 8'hFF; //
        SFDP_array[16'h0328] = 8'h81;
        SFDP_array[16'h0329] = 8'h66;
        SFDP_array[16'h032A] = 8'h4E;
        SFDP_array[16'h032B] = 8'hCD;
        SFDP_array[16'h032C] = 8'hCC;
        SFDP_array[16'h032D] = 8'h83;
        SFDP_array[16'h032E] = 8'h18;
        SFDP_array[16'h032F] = 8'h44;
        SFDP_array[16'h0330] = 8'h7A;
        SFDP_array[16'h0331] = 8'h75;
        SFDP_array[16'h0332] = 8'h7A;
        SFDP_array[16'h0333] = 8'h75;
        SFDP_array[16'h0334] = 8'hF7;
        SFDP_array[16'h0335] = 8'hA2;
        SFDP_array[16'h0336] = 8'hD5;
        SFDP_array[16'h0337] = 8'h5C;
        SFDP_array[16'h0338] = 8'h22;
        SFDP_array[16'h0339] = 8'hF6;
        SFDP_array[16'h033A] = 8'h5D;
        SFDP_array[16'h033B] = 8'hFF;
        SFDP_array[16'h033C] = 8'hE8;
        SFDP_array[16'h033D] = 8'h50;
        SFDP_array[16'h033E] = 8'hF8;
        SFDP_array[16'h033F] = 8'hA1;
        // 4-byte Address Instruction, JEDEC SFDP Rev B
        SFDP_array[16'h0340] = 8'hFB;
        SFDP_array[16'h0341] = 8'h8E;
        SFDP_array[16'h0342] = 8'hF3;
        SFDP_array[16'h0343] = 8'hFF;
        SFDP_array[16'h0344] = 8'h21;
        SFDP_array[16'h0345] = 8'h52;
        SFDP_array[16'h0346] = 8'hDC;
        SFDP_array[16'h0347] = 8'hFF;
        for (i=16'h0348; i<16'h0600; i=i+1)
        begin
            SFDP_array[i] = 8'hFF; // undefined space
        end
    end

    always @(next_state or PoweredUp or falling_edge_RST or HW_RST_out or
    SFT_RST_out)
    begin: StateTransition1
        if (PoweredUp)
        begin
            if ((!RESETNeg || !IO3_RESETNeg) &&
                                         falling_edge_RST)
            begin
            // no state transition while RESET# low
                current_state = RESET_STATE;
                HW_RST_in = 1'b1;
                HW_RST_in <= #1 1'b0;
                reseted   = 1'b0;
            end
            else if (HW_RST_out && SFT_RST_out)
            begin
                current_state <= next_state;
                reseted = 1;
            end
            if (!SFT_RST_out)
            begin
                current_state = RESET_STATE;
                reseted   = 1'b0;
            end
        end
    end

    always @(negedge RESETNeg or negedge IO3_RESETNeg)
    begin:HW_RESET
            // hw reset ignored during WRR operation and WRAR to NV Status and
            // Configuration registers
        if (!RESETNeg)
        begin
            if (!WRR_NV_ACT && !(WRAR_NV_ACT && (Address==24'd0 ||
            Address==24'd2 || Address==24'd3 || Address==24'd4)))
                RST <= #200000 RESETNeg;
        end

        if (!IO3_RESETNeg && CR2V[7] && (CSNeg_ipd || (!QUAD  && !QPI)))
        begin
            if (!WRR_NV_ACT && !(WRAR_NV_ACT && (Address==23'd0 ||
            Address==24'd2 || Address==24'd3 || Address==24'd4)))
                RST <= #200000 IO3_RESETNeg;
        end

    end

    always @(posedge RESETNeg)
    begin
        if (PoweredUp)
        begin
            if (RESETNeg)
            begin
                disable HW_RESET;
                RST = 1'b1;
            end
        end
    end

    always @(posedge IO3_RESETNeg)
    begin
        if (PoweredUp)
        begin
            if (IO3_RESETNeg && CR2V[7])
            begin
                disable HW_RESET;
                RST = 1'b1;
            end
        end
    end

    always @(negedge CSNeg_ipd)
    begin:CheckCSOnPowerUP
        if (~PoweredUp)
            $display ("Device is selected during Power Up");
    end

    ///////////////////////////////////////////////////////////////////////////
    //// Internal Delays
    ///////////////////////////////////////////////////////////////////////////

    always @(posedge PRGSUSP_in)
    begin:PRGSuspend
        PRGSUSP_out = 1'b0;
        #tdevice_SUSP PRGSUSP_out = 1'b1;
    end

    always @(posedge ERSSUSP_in)
    begin:ERSSuspend
        ERSSUSP_out = 1'b0;
        #tdevice_SUSP ERSSUSP_out = 1'b1;
    end

    always @(posedge PASSULCK_in)
    begin:PASSULock
        PASSULCK_out = 1'b0;
        #tdevice_PASSACC PASSULCK_out = 1'b1;
    end

    always @(posedge DPD_in)
    begin:DPDown
        DPD_out = 1'b0;
        #tdevice_DPD DPD_out = 1'b1;
    end

    always @(posedge RES_in)
    begin:DPDRes
        RES_out = 1'b0;
        #tdevice_RES RES_out = 1'b1;
    end

    always @(posedge QEN_in)
    begin:QPIEn
        QEN_out = 1'b0;
        #tdevice_QEN QEN_out = 1'b1;
    end

    always @(posedge QEXN_in)
    begin:QPIEx
        QEXN_out = 1'b0;
        #tdevice_QEXN QEXN_out = 1'b1;
    end
    // Timing control for the Hardware Reset
    always @(posedge HW_RST_in)
    begin:HW_RST
        HW_RST_out = 1'b0;
        #tdevice_RPH HW_RST_out = 1'b1;
    end
    // Timing control for the Software Reset
    always @(posedge SFT_RST_in)
    begin:SFT_RST
        SFT_RST_out = 1'b0;
        #tdevice_RPH SFT_RST_out = 1'b1;
    end

///////////////////////////////////////////////////////////////////////////////
// write cycle decode
///////////////////////////////////////////////////////////////////////////////


///////////////////////////////////////////////////////////////////////////////
// Timing control for the Page Program
///////////////////////////////////////////////////////////////////////////////
    time  pob;
    time  elapsed_pgm;
    time  start_pgm;
    time  duration_pgm;
    event pdone_event;

    always @(rising_edge_PSTART or rising_edge_reseted)
    begin : ProgTime

        if (wr_cnt==1)
            pob = tdevice_BP1;
        else if (wr_cnt==PageSize)
            pob = tdevice_PP;
        else
            pob = tdevice_BP1 + wr_cnt*tdevice_BP2;
        if (IRP_ACT)
            pob = tdevice_BP1 + tdevice_BP2;
        if (PASS_PGM_ACT)
            pob = tdevice_BP1 + 7*tdevice_BP2;

        if (rising_edge_reseted)
        begin
            PDONE = 1; // reset done, programing terminated
            disable pdone_process;
        end
        else if (reseted)
        begin
            if (rising_edge_PSTART && PDONE)
            begin
                elapsed_pgm = 0;
                duration_pgm = pob;
                PDONE = 1'b0;
                start_pgm = $time;
                ->pdone_event;
            end
        end
    end

    always @(posedge PGSUSP)
    begin
        if (PGSUSP && (~PDONE))
        begin
            disable pdone_process;
            elapsed_pgm = $time - start_pgm;
            duration_pgm = duration_pgm - elapsed_pgm;
            PDONE = 1'b0;
        end
    end

    always @(posedge PGRES)
    begin
        start_pgm = $time;
        ->pdone_event;
    end

    always @(pdone_event)
    begin : pdone_process
        #(duration_pgm) PDONE = 1;
    end

///////////////////////////////////////////////////////////////////////////////
// Timing control for the Write Status Register
///////////////////////////////////////////////////////////////////////////////
    time  wob;
    event wdone_event;
    event csdone_event;

    always @(rising_edge_WSTART_NV or rising_edge_WSTART_V or rising_edge_reseted)
    begin:WriteTime

        if (rising_edge_reseted)
        begin
            WDONE = 1; // reset done, Write terminated
            disable wdone_process;
        end
        else if (reseted)
        begin
            if (rising_edge_WSTART_NV && WDONE)
            begin
                wob = tdevice_WRR;
                WDONE = 1'b0;
                -> wdone_event;
            end
            else if (rising_edge_WSTART_V && WDONE)
            begin
                wob = tdevice_CS;
                WDONE = 1'b0;
                -> wdone_event;
            end
        end
    end

    always @(wdone_event)
    begin : wdone_process
        #wob WDONE = 1;
    end

///////////////////////////////////////////////////////////////////////////////
// Timing control for Erase
///////////////////////////////////////////////////////////////////////////////
    event edone_event;
    time elapsed_ers;
    time start_ers;
    time duration_ers;

    always @(rising_edge_ESTART or rising_edge_reseted)
    begin : ErsTime
        if (SECT_ERS_ACT)
            duration_ers = tdevice_SE;
        else if (HALF_BLOCK_ERS_ACT)
            duration_ers = tdevice_HBE;
        else if (BLOCK_ERS_ACT)
            duration_ers = tdevice_BE;
        else if (CHIP_ERS_ACT)
            duration_ers = tdevice_CE;
        else
            duration_ers = tdevice_SE;

        if (rising_edge_reseted)
        begin
            EDONE = 1; // reset done, ERASE terminated
            disable edone_process;
        end
        else if (reseted)
        begin
            if (rising_edge_ESTART && EDONE)
            begin
                elapsed_ers = 0;
                EDONE = 1'b0;
                start_ers = $time;
                ->edone_event;
            end
        end
    end

    always @(posedge ESUSP)
    begin
        if (ESUSP && (~EDONE))
        begin
            disable edone_process;
            elapsed_ers = $time - start_ers;
            duration_ers = duration_ers - elapsed_ers;
            EDONE = 1'b0;
        end
    end

    always @(posedge ERES)
    begin
        if  (ERES && (~EDONE))
        begin
            start_ers = $time;
            ->edone_event;
        end
    end

    always @(edone_event)
    begin : edone_process
        EDONE = 1'b0;
        #duration_ers EDONE = 1'b1;
    end

    ///////////////////////////////////////////////////////////////////
    // Process for clock frequency determination
    ///////////////////////////////////////////////////////////////////
    always @(posedge SCK_ipd)
    begin : clock_period
        if (SCK_ipd)
        begin
            CLK_PER = $time - LAST_CLK;
            LAST_CLK = $time;
        end
    end

//    /////////////////////////////////////////////////////////////////////////
//    // Main Behavior Process
//    // combinational process for next state generation
//    /////////////////////////////////////////////////////////////////////////

    integer i;
    integer j;

    always @(rising_edge_CSNeg_ipd or
    rising_edge_SCK_D or falling_edge_SCK_D or falling_edge_RES_in or
    rising_edge_PDONE or rising_edge_PRGSUSP_out or rising_edge_ERSSUSP_out or
    rising_edge_CSNeg_d or rising_edge_PASSULCK_out or rising_edge_SFT_RST_out
    or rising_edge_HW_RST_out or rising_edge_EDONE or rising_edge_WDONE)
    begin: StateGen1
        case (current_state)
            STANDBY :
            begin
                if (rising_edge_SCK_D && !CSNeg_ipd)
                begin
                    if (Instruct==READ || Instruct==READ4)
                        next_state <= RD_ADDR;
                    else if (Instruct==FAST_READ || Instruct==FAST_READ4)
                        next_state <= FAST_RD_ADDR;
                    else if (Instruct==DOR || Instruct==DOR4)
                        next_state <= DUALO_RD_ADDR;
                    else if (Instruct==DIOR || Instruct==DIOR4)
                        next_state <= DUALIO_RD_ADDR;
                    else if (Instruct==QOR || Instruct==QOR4)
                    begin
                        if (QUAD)
                            next_state <= QUADO_RD_ADDR;
                    end
                    else if (Instruct==QIOR || Instruct==QIOR4)
                    begin
                        if (QUAD || QPI)
                            next_state <= QUADIO_RD_ADDR;
                    end
                    else if (Instruct==DDRQIOR || Instruct==DDRQIOR4)
                    begin
                        if (QUAD || QPI)
                            next_state <= DDRQUADIO_RD_ADDR;
                    end
                    else if (Instruct==DLPRD)
                        next_state <= DLPRD_DUMMY;
                    else if (Instruct==IRPRD)
                        next_state <= IRPRD_DUMMY;
                    else if (Instruct==IBLRD || Instruct==IBLRD4)
                        next_state <= IBLRD_ADDR;
                    else if (Instruct==SECRR)
                        next_state <= SECRR_ADDR;
                    else if (Instruct==PASSRD && IRP[2])
                        next_state <= PASSRD_DUMMY;
                    else if (Instruct==PRRD)
                        next_state <= PRRD_DUMMY;
                    else if (Instruct==RDID)
                        next_state <= RDID_DATA_OUTPUT;
                    else if (Instruct==RDQID)
                    begin
                        if (QUAD || QPI)
                            next_state <= RDQID_DATA_OUTPUT;
                    end
                    else if (Instruct==RUID)
                        next_state <= RUID_DUMMY;
                    else if (Instruct==RSFDP)
                        next_state <= RSFDP_ADDR;
                    else if (Instruct==SET_BURST)
                        next_state <= SET_BURST_DATA_INPUT;
                    else if (Instruct==RDSR1)
                        next_state <= RDSR1_DATA_OUTPUT;
                    else if (Instruct==RDSR2)
                        next_state <= RDSR2_DATA_OUTPUT;
                    else if (Instruct==RDCR1)
                        next_state <= RDCR1_DATA_OUTPUT;
                    else if (Instruct==RDCR2)
                        next_state <= RDCR2_DATA_OUTPUT;
                    else if (Instruct==RDCR3)
                        next_state <= RDCR3_DATA_OUTPUT;
                    else if (Instruct==RDAR)
                        next_state <= RDAR_ADDR;
                    else if (Instruct==RES)
                        next_state <= RDP_DUMMY;
                    else if (Instruct==PP || Instruct==PP4)
                    begin
                        if (WEL == 1'b1)
                            next_state <= PGM_ADDR;
                    end
                    else if (Instruct==QPP || Instruct==QPP4)
                    begin
                        if (WEL == 1'b1 && QUAD)
                            next_state <= PGM_ADDR;
                    end
                    else if (Instruct==SE || Instruct==SE4)
                    begin
                        if (WEL == 1'b1)
                            next_state <= SECT_ERS_ADDR;
                    end
                    else if (Instruct==HBE || Instruct==HBE4)
                    begin
                        if (WEL == 1'b1)
                            next_state <= HALF_BLOCK_ERS_ADDR;
                    end
                    else if (Instruct==BE || Instruct==BE4)
                    begin
                        if (WEL == 1'b1)
                            next_state <= BLOCK_ERS_ADDR;
                    end
                    else if (Instruct==IBL || Instruct==IBL4)
                    begin
                        if (WPS == 1'b1)
                            next_state <= IBL_LOCK;
                    end
                    else if (Instruct==IRPP)
                    begin
                        if (WEL == 1'b1)
                            next_state <= IRP_PGM_DATA_INPUT;
                    end
                    else if (Instruct==WRR)
                    begin
                        if (WEL == 1'b1 || WREN_V == 1'b1)
                            next_state <= WRR_DATA_INPUT;
                    end
                    else if (Instruct==WRAR)
                    begin
                        if (WEL == 1'b1)
                            next_state <= WRAR_ADDR;
                    end
                    else if (Instruct==PASSP)
                    begin
                        if (WEL == 1'b1)
                            if (IRP[2] == 1'b1)
                                next_state <= PASSP_DATA_INPUT;
                    end
                    else if (Instruct==SECRP)
                    begin
                        if (WEL == 1'b1)
                            next_state <= SEC_REG_PGM_ADDR;
                    end
                    else if (Instruct==SECRE)
                    begin
                        if (WEL == 1'b1)
                            next_state <= SEC_REG_ERS_ADDR;
                    end
                    else if (Instruct==PASSU)
                    begin
                        next_state <= PASSU_DATA_INPUT;
                    end
                    else if (Instruct==IBUL || Instruct==IBUL4)
                    begin
                        if (WPS == 1'b1)
                            next_state <= IBL_UNLOCK;
                    end
                    else if (Instruct==SPRP || Instruct==SPRP4)
                    begin
                        if (WEL == 1'b1)
                            if (NVLOCK == 1'b1)
                                next_state <= SET_PNTR_PROT_ADDR;
                    end
                    else if (Instruct==PDLRNV)
                    begin
                        if (!srp1 && (!srp0 || WPNeg_in || QUAD || QPI))
                            if (WEL == 1'b1)
                                if (!DLRNV_programmed) // OTP
                                    next_state <= PGM_NV_DLR_DATA;
                    end
                    else if (Instruct==WDLRV)
                    begin
                        if (!srp1 && (!srp0 || WPNeg_in || QUAD || QPI))
                            if (WEL == 1'b1)
                                next_state <= DLRV_WRITE_DATA;
                    end
                end
                if (rising_edge_CSNeg_ipd)
                begin
                    if (opcode_cnt==8)
                    begin
                        if (Instruct==RSTEN)
                            next_state <= SFT_RST_EN;
                        else if (Instruct==DEEP_PD)
                            next_state <= DPD;
                        else if (Instruct==CE)
                        begin
                            if (WEL == 1'b1)
                                next_state <= CHIP_ERS;
                        end
                    end
                end
            end

            SFT_RST_EN :
            begin
                if (rising_edge_CSNeg_ipd)
                begin
                    if (opcode_cnt==8)
                    begin
                        if (Instruct==RSTCMD)
                            next_state = RESET_STATE;
                        else
                            next_state = STANDBY;
                    end
                end
            end

            RESET_STATE :
            begin
                if (rising_edge_SFT_RST_out || rising_edge_HW_RST_out)
                    if (SFT_RST_out &&  HW_RST_out)
                        next_state = STANDBY;
            end

            DPD :
            begin
                if (rising_edge_SCK_D && !CSNeg_ipd)
                begin
                    if (opcode_cnt==9)
                        if (Instruct==RES)
                            next_state <= RDP_DUMMY;
                end
                if (falling_edge_RES_in)
                    next_state <= STANDBY;
            end

            RD_ADDR :
            begin
                if (rising_edge_SCK_D && !CSNeg_ipd)
                begin
                    if ((Instruct==READ) && !CR2V[0])
                    begin
                        if (addr_cnt == 24)
                            next_state <= RD_DATA;
                    end
                    else if ((Instruct==READ4) ||
                    ((Instruct==READ) && CR2V[0]))
                    begin
                        if (addr_cnt == 32)
                            next_state <= RD_DATA;
                    end
                end

                if (rising_edge_CSNeg_ipd)
                begin
                    if (SR2V[0])
                        next_state <= PGMSUS;
                    else if (SR2V[1])
                        next_state <= ERSSUS;
                    else
                        next_state <= STANDBY;
                end
            end

            RD_DATA, FAST_RD_DATA, DUALO_RD_DATA, QUADO_RD_DATA :
            begin
                if (rising_edge_CSNeg_ipd)
                begin
                    if (SR2V[0])
                        next_state <= PGMSUS;
                    else if (SR2V[1])
                        next_state <= ERSSUS;
                    else
                        next_state <= STANDBY;
                end
            end

            FAST_RD_ADDR :
            begin
                if (rising_edge_SCK_D && !CSNeg_ipd)
                begin
                    if (Instruct==FAST_READ && !CR2V[0])
                    begin
                        if (addr_cnt == 24)
                            next_state <= FAST_RD_DUMMY;
                    end
                    else if (Instruct==FAST_READ4 ||
                    (Instruct==FAST_READ && CR2V[0]))
                    begin
                        if (addr_cnt == 32)
                            next_state <= FAST_RD_DUMMY;
                    end
                end
                if (rising_edge_CSNeg_ipd)
                begin
                    if (SR2V[0])
                        next_state <= PGMSUS;
                    else if (SR2V[1])
                        next_state <= ERSSUS;
                    else
                        next_state <= STANDBY;
                end
            end

            FAST_RD_DUMMY :
            begin
                if (rising_edge_SCK_D && !CSNeg_ipd)
                begin
                    if (dummy_cnt == Latency_code)
                        next_state <= FAST_RD_DATA;
                end
                if (rising_edge_CSNeg_ipd)
                begin
                    if (SR2V[0])
                        next_state <= PGMSUS;
                    else if (SR2V[1])
                        next_state <= ERSSUS;
                    else
                        next_state <= STANDBY;
                end
            end

            DUALO_RD_ADDR :
            begin
                if (rising_edge_SCK_D && !CSNeg_ipd)
                begin
                    if (Instruct==DOR && !CR2V[0])
                    begin
                        if (addr_cnt == 24)
                            next_state <= DUALO_RD_DUMMY;
                    end
                    else if (Instruct==DOR4 ||
                    (Instruct==DOR && CR2V[0]))
                    begin
                        if (addr_cnt == 32)
                            next_state <= DUALO_RD_DUMMY;
                    end
                end
                if (rising_edge_CSNeg_ipd)
                begin
                    if (SR2V[0])
                        next_state <= PGMSUS;
                    else if (SR2V[1])
                        next_state <= ERSSUS;
                    else
                        next_state <= STANDBY;
                end
            end

            DUALO_RD_DUMMY :
            begin
                if (rising_edge_SCK_D && !CSNeg_ipd)
                begin
                    if (dummy_cnt == Latency_code)
                        next_state <= DUALO_RD_DATA;
                end
                if (rising_edge_CSNeg_ipd)
                begin
                    if (SR2V[0])
                        next_state <= PGMSUS;
                    else if (SR2V[1])
                        next_state <= ERSSUS;
                    else
                        next_state <= STANDBY;
                end
            end

            QUADO_RD_ADDR :
            begin
                if (rising_edge_SCK_D && !CSNeg_ipd)
                begin
                    if (Instruct==QOR && !CR2V[0])
                    begin
                        if (addr_cnt == 24)
                            next_state <= QUADO_RD_DUMMY;
                    end
                    else if (Instruct==QOR4 ||
                    (Instruct==QOR && CR2V[0]))
                    begin
                        if (addr_cnt == 32)
                            next_state <= QUADO_RD_DUMMY;
                    end
                end
                if (rising_edge_CSNeg_ipd)
                begin
                    if (SR2V[0])
                        next_state <= PGMSUS;
                    else if (SR2V[1])
                        next_state <= ERSSUS;
                    else
                        next_state <= STANDBY;
                end
            end

            QUADO_RD_DUMMY :
            begin
                if (rising_edge_SCK_D && !CSNeg_ipd)
                begin
                    if (dummy_cnt == Latency_code)
                        next_state <= QUADO_RD_DATA;
                end
                if (rising_edge_CSNeg_ipd)
                begin
                    if (SR2V[0])
                        next_state <= PGMSUS;
                    else if (SR2V[1])
                        next_state <= ERSSUS;
                    else
                        next_state <= STANDBY;
                end
            end

            DUALIO_RD_ADDR :
            begin
                if (rising_edge_SCK_D && !CSNeg_ipd)
                begin
                    if (Instruct==DIOR && !CR2V[0])
                    begin
                        if (addr_cnt == 24)
                            next_state <= DUALIO_RD_MODE;
                    end
                    else if (Instruct==DIOR4 ||
                    (Instruct==DIOR && CR2V[0]))
                    begin
                        if (addr_cnt == 32)
                            next_state <= DUALIO_RD_MODE;
                    end
                end
                if (rising_edge_CSNeg_ipd)
                begin
                    if (SR2V[0])
                        next_state <= PGMSUS;
                    else if (SR2V[1])
                        next_state <= ERSSUS;
                    else
                        next_state <= STANDBY;
                end
            end

            DUALIO_RD_MODE :
            begin
                if (rising_edge_SCK_D && !CSNeg_ipd)
                begin
                    if (mode_cnt == 8)
                        next_state <= DUALIO_RD_DUMMY;
                end
                if (rising_edge_CSNeg_ipd)
                begin
                    if (SR2V[0])
                        next_state <= PGMSUS;
                    else if (SR2V[1])
                        next_state <= ERSSUS;
                    else
                        next_state <= STANDBY;
                end
            end

            DUALIO_RD_DUMMY :
            begin
                if (rising_edge_SCK_D && !CSNeg_ipd)
                begin
                    if (dummy_cnt == Latency_code)
                        next_state <= DUALIO_RD_DATA;
                end
                if (rising_edge_CSNeg_ipd)
                begin
                    if (SR2V[0])
                        next_state <= PGMSUS;
                    else if (SR2V[1])
                        next_state <= ERSSUS;
                    else
                        next_state <= STANDBY;
                end
            end

            DUALIO_RD_DATA :
            begin
                if (rising_edge_CSNeg_ipd)
                begin
                    if (mode_byte[7:4] == 4'b1010)
                        next_state <= DUALIO_RD_ADDR;
                    else
                    begin
                        if (SR2V[0])
                            next_state <= PGMSUS;
                        else if (SR2V[1])
                            next_state <= ERSSUS;
                        else
                            next_state <= STANDBY;
                    end
                end
            end

            QUADIO_RD_ADDR :
            begin
                if (rising_edge_SCK_D && !CSNeg_ipd)
                begin
                    if (Instruct==QIOR && !CR2V[0])
                    begin
                        if (addr_cnt == 24)
                            next_state <= QUADIO_RD_MODE;
                    end
                    else if (Instruct==QIOR4 ||
                    (Instruct==QIOR && CR2V[0]))
                    begin
                        if (addr_cnt == 32)
                            next_state <= QUADIO_RD_MODE;
                    end
                end
                if (rising_edge_CSNeg_ipd)
                begin
                    if (SR2V[0])
                        next_state <= PGMSUS;
                    else if (SR2V[1])
                        next_state <= ERSSUS;
                    else
                        next_state <= STANDBY;
                end
            end

            QUADIO_RD_MODE :
            begin
                if (rising_edge_SCK_D && !CSNeg_ipd)
                begin
                    if (mode_cnt == 8)
                        next_state <= QUADIO_RD_DUMMY;
                end
                if (rising_edge_CSNeg_ipd)
                begin
                    if (SR2V[0])
                        next_state <= PGMSUS;
                    else if (SR2V[1])
                        next_state <= ERSSUS;
                    else
                        next_state <= STANDBY;
                end
            end

            QUADIO_RD_DUMMY :
            begin
                if (rising_edge_SCK_D && !CSNeg_ipd)
                begin
                    if (dummy_cnt == Latency_code)
                        next_state <= QUADIO_RD_DATA;
                end
                if (rising_edge_CSNeg_ipd)
                begin
                    if (SR2V[0])
                        next_state <= PGMSUS;
                    else if (SR2V[1])
                        next_state <= ERSSUS;
                    else
                        next_state <= STANDBY;
                end
            end

            QUADIO_RD_DATA :
            begin
                if (rising_edge_CSNeg_ipd)
                begin
                    if (mode_byte[7:4] == 4'b1010)
                        next_state <= QUADIO_RD_ADDR;
                    else
                    begin
                        if (SR2V[0])
                            next_state <= PGMSUS;
                        else if (SR2V[1])
                            next_state <= ERSSUS;
                        else
                            next_state <= STANDBY;
                    end
                end
            end

            DDRQUADIO_RD_ADDR :
            begin
                if (falling_edge_SCK_D && !CSNeg_ipd)
                begin
                    if (Instruct==DDRQIOR && !CR2V[0])
                    begin
                        if (addr_cnt == 24)
                            next_state <= DDRQUADIO_RD_MODE;
                    end
                    else if (Instruct==DDRQIOR4 ||
                    (Instruct==DDRQIOR && CR2V[0]))
                    begin
                        if (addr_cnt == 32)
                            next_state <= DDRQUADIO_RD_MODE;
                    end
                end
                if (rising_edge_CSNeg_ipd)
                begin
                    if (SR2V[0])
                        next_state <= PGMSUS;
                    else if (SR2V[1])
                        next_state <= ERSSUS;
                    else
                        next_state <= STANDBY;
                end
            end

            DDRQUADIO_RD_MODE :
            begin
                if (falling_edge_SCK_D && !CSNeg_ipd)
                begin
                    if (mode_cnt == 8)
                        next_state <= DDRQUADIO_RD_DUMMY;
                end
                if (rising_edge_CSNeg_ipd)
                begin
                    if (SR2V[0])
                        next_state <= PGMSUS;
                    else if (SR2V[1])
                        next_state <= ERSSUS;
                    else
                        next_state <= STANDBY;
                end
            end

            DDRQUADIO_RD_DUMMY :
            begin
                if (rising_edge_SCK_D && !CSNeg_ipd)
                begin
                    if (dummy_cnt == 2*Latency_code )
                        next_state <= DDRQUADIO_RD_DATA;
                end
                if (rising_edge_CSNeg_ipd)
                begin
                    if (SR2V[0])
                        next_state <= PGMSUS;
                    else if (SR2V[1])
                        next_state <= ERSSUS;
                    else
                        next_state <= STANDBY;
                end
            end

            DDRQUADIO_RD_DATA :
            begin
                if (rising_edge_CSNeg_ipd)
                begin
                  if (mode_byte[7:4] == ~mode_byte[3:0])
                        next_state <= DDRQUADIO_RD_ADDR;
                  else
                  begin
                    if (SR2V[0])
                        next_state <= PGMSUS;
                    else if (SR2V[1])
                        next_state <= ERSSUS;
                    else
                        next_state <= STANDBY;
                  end
                end
            end

            RDAR_ADDR :
            begin
                if (rising_edge_SCK_D && !CSNeg_ipd)
                begin
                    if ((!CR2V[0] && addr_cnt==24) ||
                    (CR2V[0] && addr_cnt==32))
                        next_state <= RDAR_DUMMY;
                end

                // if the Read Any Register is broken early (in address phase)
                if (rising_edge_CSNeg_ipd)
                begin
                    next_state <= STANDBY;
                    if (CHIP_ERS_ACT)
                        next_state <= CHIP_ERS;
                    if (SECT_ERS_ACT)
                        next_state <= SECT_ERS;
                    if (HALF_BLOCK_ERS_ACT)
                        next_state <= HALF_BLOCK_ERS;
                    if (BLOCK_ERS_ACT)
                        next_state <= BLOCK_ERS;
                    if (SR2V[1])
                        next_state <= ERSSUS;
                    if (PGM_ACT)
                        next_state <= PGM;
                    if (SR2V[0])
                        next_state <= PGMSUS;
                    if (PGM_SEC_REG_ACT)
                        next_state <= PGM_SEC_REG;
                    if (SECT_ERS_SEC_REG_ACT)
                        next_state <= SECT_ERS_SEC_REG;
                    if (WRR_NV_ACT)
                        next_state <= WRR_NV;
                    if (WRAR_NV_ACT)
                        next_state <= WRAR_NV;
                    if (IRP_ACT)
                        next_state <= IRP_PGM;
                    if (DLRNV_ACT)
                        next_state <= PGM_NV_DLR;
                    if (SET_PNTR_PROT_ACT)
                        next_state <= SET_PNTR_PROT;
                    if (PASS_PGM_ACT)
                        next_state <= PASS_PGM;
                    if (PASSULCK_in)
                        next_state <= PASS_ULCK;
                end
            end

            RDAR_DUMMY :
            begin
                if (rising_edge_SCK_D && !CSNeg_ipd)
                begin
                    if (dummy_cnt == Latency_code)
                        next_state <= RDAR_DATA_OUTPUT;
                end

                // if the Read Any Register is broken early (in dummy phase)
                if (rising_edge_CSNeg_ipd)
                begin
                    next_state <= STANDBY;
                    if (CHIP_ERS_ACT)
                        next_state <= CHIP_ERS;
                    if (SECT_ERS_ACT)
                        next_state <= SECT_ERS;
                    if (HALF_BLOCK_ERS_ACT)
                        next_state <= HALF_BLOCK_ERS;
                    if (BLOCK_ERS_ACT)
                        next_state <= BLOCK_ERS;
                    if (SR2V[1])
                        next_state <= ERSSUS;
                    if (PGM_ACT)
                        next_state <= PGM;
                    if (SR2V[0])
                        next_state <= PGMSUS;
                    if (PGM_SEC_REG_ACT)
                        next_state <= PGM_SEC_REG;
                    if (SECT_ERS_SEC_REG_ACT)
                        next_state <= SECT_ERS_SEC_REG;
                    if (WRR_NV_ACT)
                        next_state <= WRR_NV;
                    if (WRAR_NV_ACT)
                        next_state <= WRAR_NV;
                    if (IRP_ACT)
                        next_state <= IRP_PGM;
                    if (DLRNV_ACT)
                        next_state <= PGM_NV_DLR;
                    if (SET_PNTR_PROT_ACT)
                        next_state <= SET_PNTR_PROT;
                    if (PASS_PGM_ACT)
                        next_state <= PASS_PGM;
                    if (PASSULCK_in)
                        next_state <= PASS_ULCK;
                end
            end

            RDSR1_DATA_OUTPUT, RDSR2_DATA_OUTPUT, RDCR1_DATA_OUTPUT,
            RDCR2_DATA_OUTPUT, RDCR3_DATA_OUTPUT, RDAR_DATA_OUTPUT:
            begin
                if (rising_edge_CSNeg_ipd)
                begin
                    next_state <= STANDBY;
                    if (CHIP_ERS_ACT)
                        next_state <= CHIP_ERS;
                    if (SECT_ERS_ACT)
                        next_state <= SECT_ERS;
                    if (HALF_BLOCK_ERS_ACT)
                        next_state <= HALF_BLOCK_ERS;
                    if (BLOCK_ERS_ACT)
                        next_state <= BLOCK_ERS;
                    if (SR2V[1])
                        next_state <= ERSSUS;
                    if (PGM_ACT)
                        next_state <= PGM;
                    if (SR2V[0])
                        next_state <= PGMSUS;
                    if (PGM_SEC_REG_ACT)
                        next_state <= PGM_SEC_REG;
                    if (SECT_ERS_SEC_REG_ACT)
                        next_state <= SECT_ERS_SEC_REG;
                    if (WRR_NV_ACT)
                        next_state <= WRR_NV;
                    if (WRAR_NV_ACT)
                        next_state <= WRAR_NV;
                    if (IRP_ACT)
                        next_state <= IRP_PGM;
                    if (DLRNV_ACT)
                        next_state <= PGM_NV_DLR;
                    if (SET_PNTR_PROT_ACT)
                        next_state <= SET_PNTR_PROT;
                    if (PASS_PGM_ACT)
                        next_state <= PASS_PGM;
                    if (PASSULCK_in)
                        next_state <= PASS_ULCK;
                end
            end

            DLPRD_DUMMY :
            begin
                if (rising_edge_SCK_D && !CSNeg_ipd)
                begin
                    if (dummy_cnt == Latency_code)
                        next_state <= DLPRD_DATA_OUTPUT;
                end
                if (rising_edge_CSNeg_ipd)
                begin
                    if (SR2V[0])
                        next_state <= PGMSUS;
                    else if (SR2V[1])
                        next_state <= ERSSUS;
                    else
                        next_state <= STANDBY;
                end
            end

            DLPRD_DATA_OUTPUT:
            begin
                if (rising_edge_CSNeg_ipd)
                begin
                    if (SR2V[0])
                        next_state <= PGMSUS;
                    else if (SR2V[1])
                        next_state <= ERSSUS;
                    else
                        next_state <= STANDBY;
                end
            end

            IRPRD_DUMMY :
            begin
                if (rising_edge_SCK_D && !CSNeg_ipd)
                begin
                    if (dummy_cnt == Latency_code)
                        next_state <= IRPRD_DATA_OUTPUT;
                end
               if (rising_edge_CSNeg_ipd)
                    next_state <= STANDBY;
            end

            IRPRD_DATA_OUTPUT:
            begin
                if (rising_edge_CSNeg_ipd)
                    next_state <= STANDBY;
            end

            IBLRD_ADDR :
            begin
                if (rising_edge_SCK_D && !CSNeg_ipd)
                begin
                    if ((Instruct==IBLRD && ((!CR2V[0] && addr_cnt==24) ||
                    (CR2V[0] && addr_cnt==32))) ||
                    (Instruct==IBLRD4 && addr_cnt==32))
                        next_state <= IBLRD_DATA_OUTPUT;
                end

                if (rising_edge_CSNeg_ipd)
                begin
                    if (SR2V[0])
                        next_state <= PGMSUS;
                    else if (SR2V[1])
                        next_state <= ERSSUS;
                    else
                        next_state <= STANDBY;
                end

            end

            IBLRD_DATA_OUTPUT:
            begin
                if (rising_edge_CSNeg_ipd)
                begin
                    if (SR2V[0])
                        next_state <= PGMSUS;
                    else if (SR2V[1])
                        next_state <= ERSSUS;
                    else
                        next_state <= STANDBY;
                end
            end

            SECRR_ADDR :
            begin
                if (falling_edge_SCK_D && !CSNeg_ipd)
                begin
                    if ((!CR2V[0] && addr_cnt==24) ||
                    (CR2V[0] && addr_cnt==32))
                        next_state <= SECRR_DUMMY;
                end
                if (rising_edge_CSNeg_ipd)
                begin
                    if (SR2V[0])
                        next_state <= PGMSUS;
                    else if (SR2V[1])
                        next_state <= ERSSUS;
                    else
                        next_state <= STANDBY;
                end
            end

            SECRR_DUMMY :
            begin
                if (rising_edge_SCK_D && !CSNeg_ipd)
                begin
                    if (dummy_cnt == Latency_code)
                        next_state <= SECRR_DATA_OUTPUT;
                end
                if (rising_edge_CSNeg_ipd)
                begin
                    if (SR2V[0])
                        next_state <= PGMSUS;
                    else if (SR2V[1])
                        next_state <= ERSSUS;
                    else
                        next_state <= STANDBY;
                end
            end

            SECRR_DATA_OUTPUT:
            begin
                if (rising_edge_CSNeg_ipd)
                begin
                    if (SR2V[0])
                        next_state <= PGMSUS;
                    else if (SR2V[1])
                        next_state <= ERSSUS;
                    else
                        next_state <= STANDBY;
                end
            end

            PASSRD_DUMMY :
            begin
                if (rising_edge_SCK_D && !CSNeg_ipd)
                begin
                    if (dummy_cnt == Latency_code)
                        next_state <= PASSRD_DATA_OUTPUT;
                end
                if (rising_edge_CSNeg_ipd)
                    next_state <= STANDBY;
            end

            PASSRD_DATA_OUTPUT:
            begin
                if (rising_edge_CSNeg_ipd)
                    next_state <= STANDBY;
            end

            PRRD_DUMMY :
            begin
                if (rising_edge_SCK_D && !CSNeg_ipd)
                begin
                    if (dummy_cnt == Latency_code)
                        next_state <= PRRD_DATA_OUTPUT;
                end
                if (rising_edge_CSNeg_ipd)
                    next_state <= STANDBY;
            end

            PRRD_DATA_OUTPUT:
            begin
                if (rising_edge_CSNeg_ipd)
                    next_state <= STANDBY;
            end

            RDID_DATA_OUTPUT, RDQID_DATA_OUTPUT:
            begin
                if (rising_edge_CSNeg_ipd)
                begin
                    if (SR2V[0])
                        next_state <= PGMSUS;
                    else if (SR2V[1])
                        next_state <= ERSSUS;
                    else
                        next_state <= STANDBY;
                end
            end

            RUID_DUMMY :
            begin
                if (rising_edge_SCK_D && !CSNeg_ipd)
                begin
                    if (dummy_cnt == Latency_code)
                        next_state <= RUID_DATA_OUTPUT;
                end
                if (rising_edge_CSNeg_ipd)
                begin
                    if (SR2V[0])
                        next_state <= PGMSUS;
                    else if (SR2V[1])
                        next_state <= ERSSUS;
                    else
                        next_state <= STANDBY;
                end
            end

            RUID_DATA_OUTPUT:
            begin
                if (rising_edge_CSNeg_ipd)
                begin
                    if (SR2V[0])
                        next_state <= PGMSUS;
                    else if (SR2V[1])
                        next_state <= ERSSUS;
                    else
                        next_state <= STANDBY;
                end
            end

            RSFDP_ADDR :
            begin
                if (falling_edge_SCK_D && !CSNeg_ipd)
                begin
                    if ((!CR2V[0] && addr_cnt==24) ||
                    (CR2V[0] && addr_cnt==32))
                        next_state <= RSFDP_DUMMY;
                end
                if (rising_edge_CSNeg_ipd)
                begin
                    if (SR2V[0])
                        next_state <= PGMSUS;
                    else if (SR2V[1])
                        next_state <= ERSSUS;
                    else
                        next_state <= STANDBY;
                end
            end

            RSFDP_DUMMY :
            begin
                if (rising_edge_SCK_D && !CSNeg_ipd)
                begin
                    if (dummy_cnt == Latency_code)
                        next_state <= RSFDP_DATA_OUTPUT;
                end
                if (rising_edge_CSNeg_ipd)
                begin
                    if (SR2V[0])
                        next_state <= PGMSUS;
                    else if (SR2V[1])
                        next_state <= ERSSUS;
                    else
                        next_state <= STANDBY;
                end
            end

            RSFDP_DATA_OUTPUT:
            begin
                if (rising_edge_CSNeg_ipd)
                begin
                    if (SR2V[0])
                        next_state <= PGMSUS;
                    else if (SR2V[1])
                        next_state <= ERSSUS;
                    else
                        next_state <= STANDBY;
                end
            end

            SET_BURST_DATA_INPUT :
            begin
                if (rising_edge_CSNeg_ipd)
                begin
                    if (SR2V[0])
                        next_state <= PGMSUS;
                    else if (SR2V[1])
                        next_state <= ERSSUS;
                    else
                        next_state <= STANDBY;
                end
            end

            RDP_DUMMY : //release DP
            begin
                if (rising_edge_SCK_D && !CSNeg_ipd)
                begin
                    if (dummy_cnt == 24)
                        next_state <= RDP_DATA_OUTPUT;
                end
                if (rising_edge_CSNeg_ipd)
                begin
                    if (DPD_ACT)
                        next_state <= DPD;
                    else
                        next_state <= STANDBY;
                end
            end

            RDP_DATA_OUTPUT:
            begin
                if (rising_edge_CSNeg_ipd)
                begin
                    if (DPD_ACT)
                        next_state <= DPD;
                    else
                        next_state <= STANDBY;
                end
                if (falling_edge_RES_in)// when in DPD mode
                    next_state <= STANDBY;
            end

            PGM_ADDR :
            begin
                if (rising_edge_SCK_D && !CSNeg_ipd)
                begin
                    if ((Instruct==PP || Instruct==QPP) && !CR2V[0])
                    begin
                        if (addr_cnt == 24)
                            next_state <= PGM_DATAIN;
                    end
                    else if (Instruct==PP4 || Instruct==QPP4 ||
                    ((Instruct==PP || Instruct==QPP) && CR2V[0]))
                    begin
                        if (addr_cnt == 32)
                            next_state <= PGM_DATAIN;
                    end
                end
                if (rising_edge_CSNeg_ipd)
                begin
                    if (SR2V[1])  // erase suspend
                        next_state <= ERSSUS;
                    else
                        next_state <= STANDBY;
                end
            end

            PGM_DATAIN :
            begin
                if (rising_edge_CSNeg_ipd)
                begin
                  if (data_cnt==0 && byte_cnt>0)
                        next_state <= PGM;
                  else
                  begin
                      if (SR2V[1])  // erase suspend
                          next_state <= ERSSUS;
                      else
                          next_state <= STANDBY;
                  end
                end
            end

            PGM :
            begin
                if (rising_edge_SCK_D && !CSNeg_ipd)
                begin
                    if (opcode_cnt==8)
                    begin
                        if (Instruct==RDSR1)
                            next_state <= RDSR1_DATA_OUTPUT;
                        else if (Instruct==RDSR2)
                            next_state <= RDSR2_DATA_OUTPUT;
                        else if (Instruct==RDCR1)
                            next_state <= RDCR1_DATA_OUTPUT;
                        else if (Instruct==RDCR2)
                            next_state <= RDCR2_DATA_OUTPUT;
                        else if (Instruct==RDCR3)
                            next_state <= RDCR3_DATA_OUTPUT;
                        else if (Instruct==RDAR)
                            next_state <= RDAR_ADDR;
                    end
                end

                if (rising_edge_CSNeg_ipd)
                begin
                    if (opcode_cnt==8)
                    begin
                        if (Instruct==CLSR)
                        begin
                            if (SR2V[5])
                            begin
                                if (SR2V[1])  // erase suspend
                                    next_state <= ERSSUS;
                                else
                                    next_state <= STANDBY;
                            end
                        end
                        else if (Instruct==RSTEN)
                            next_state <= SFT_RST_EN;
                    end
                end

                if (rising_edge_PRGSUSP_out)
                    next_state <= PGMSUS;
                if (rising_edge_PDONE ||
                // operation finished during status read
                (rising_edge_CSNeg_d && PDONE && !SR2V[5]))
                begin
                    if (SR2V[1])  // erase suspend
                        next_state <= ERSSUS;
                    else
                        next_state <= STANDBY;
                end
            end

            SECT_ERS_ADDR :
            begin
                if (rising_edge_CSNeg_ipd)
                begin
                    if ((Instruct == SE4 && addr_cnt == 32) ||
                    (Instruct == SE && ((!CR2V[0] && addr_cnt == 24) ||
                    (CR2V[0] && addr_cnt == 32))))
                        next_state <= SECT_ERS;
                    else
                        next_state <= STANDBY;
                end
            end

            HALF_BLOCK_ERS_ADDR :
            begin
                if (rising_edge_CSNeg_ipd)
                begin
                    if ((Instruct == HBE4 && addr_cnt == 32) ||
                    (Instruct == HBE && ((!CR2V[0] && addr_cnt == 24) ||
                    (CR2V[0] && addr_cnt == 32))))
                        next_state <= HALF_BLOCK_ERS;
                    else
                        next_state <= STANDBY;
                end
            end

            BLOCK_ERS_ADDR :
            begin
                if (rising_edge_CSNeg_ipd)
                begin
                    if ((Instruct == BE4 && addr_cnt == 32) ||
                    (Instruct == BE && ((!CR2V[0] && addr_cnt == 24) ||
                    (CR2V[0] && addr_cnt == 32))))
                        next_state <= BLOCK_ERS;
                    else
                        next_state <= STANDBY;
                end
            end

            SECT_ERS, HALF_BLOCK_ERS, BLOCK_ERS :
            begin
                if (rising_edge_SCK_D && !CSNeg_ipd)
                begin
                    if (opcode_cnt==8)
                    begin
                        if (Instruct==RDSR1)
                            next_state <= RDSR1_DATA_OUTPUT;
                        else if (Instruct==RDSR2)
                            next_state <= RDSR2_DATA_OUTPUT;
                        else if (Instruct==RDCR1)
                            next_state <= RDCR1_DATA_OUTPUT;
                        else if (Instruct==RDCR2)
                            next_state <= RDCR2_DATA_OUTPUT;
                        else if (Instruct==RDCR3)
                            next_state <= RDCR3_DATA_OUTPUT;
                        else if (Instruct==RDAR)
                            next_state <= RDAR_ADDR;
                    end
                end

                if (rising_edge_CSNeg_ipd)
                begin
                    if (opcode_cnt==8)
                    begin
                        if (Instruct==CLSR)
                        begin
                            if (SR2V[6])
                                next_state <= STANDBY;
                        end
                        else if (Instruct==RSTEN)
                            next_state <= SFT_RST_EN;
                    end
                end
                if (rising_edge_ERSSUSP_out)
                    next_state <= ERSSUS;
                if (rising_edge_EDONE ||
                // operation finished during status read)
                (rising_edge_CSNeg_d && EDONE  && !SR2V[6]))
                    next_state <= STANDBY;
            end

            CHIP_ERS :
            begin
                if (rising_edge_SCK_D && !CSNeg_ipd)
                begin
                    if (opcode_cnt==8)
                    begin
                        if (Instruct==RDSR1)
                            next_state <= RDSR1_DATA_OUTPUT;
                        else if (Instruct==RDSR2)
                            next_state <= RDSR2_DATA_OUTPUT;
                        else if (Instruct==RDCR1)
                            next_state <= RDCR1_DATA_OUTPUT;
                        else if (Instruct==RDCR2)
                            next_state <= RDCR2_DATA_OUTPUT;
                        else if (Instruct==RDCR3)
                            next_state <= RDCR3_DATA_OUTPUT;
                        else if (Instruct==RDAR)
                            next_state <= RDAR_ADDR;
                    end
                end

                if (rising_edge_CSNeg_ipd)
                begin
                    if (opcode_cnt==8)
                    begin
                        if (Instruct==CLSR)
                        begin
                            if (SR2V[6])
                                next_state = STANDBY;
                        end
                        else if (Instruct==RSTEN)
                            next_state = SFT_RST_EN;
                    end
                end
                if (rising_edge_EDONE ||
                // operation finished during status read)
                (rising_edge_CSNeg_d && EDONE  && !SR2V[6]))
                    next_state = STANDBY;
            end

            SEC_REG_PGM_ADDR :
            begin
                if (rising_edge_SCK_D && !CSNeg_ipd)
                begin
                    if (!CR2V[0])
                    begin
                        if (addr_cnt == 24)
                            next_state <= SEC_REG_PGM_DATAIN;
                    end
                    else if (CR2V[0])
                    begin
                        if (addr_cnt == 32)
                            next_state <= SEC_REG_PGM_DATAIN;
                    end
                end
                if (rising_edge_CSNeg_ipd)
                begin
                    if (SR2V[1])
                        next_state <= ERSSUS;
                    else
                        next_state <= STANDBY;
                end
            end

            SEC_REG_PGM_DATAIN :
            begin
                if (rising_edge_CSNeg_ipd)
                begin
                  if (data_cnt==0 && byte_cnt>0 &&
                  Address<=SECRHiAddr)
                      next_state <= PGM_SEC_REG;
                  else
                  begin
                      if (SR2V[1])
                          next_state <= ERSSUS;
                      else
                          next_state <= STANDBY;
                  end
                end
            end

            PGM_SEC_REG :
            begin
                if (rising_edge_SCK_D && !CSNeg_ipd)
                begin
                    if (opcode_cnt==8)
                    begin
                        if (Instruct==RDSR1)
                            next_state <= RDSR1_DATA_OUTPUT;
                        else if (Instruct==RDSR2)
                            next_state <= RDSR2_DATA_OUTPUT;
                        else if (Instruct==RDCR1)
                            next_state <= RDCR1_DATA_OUTPUT;
                        else if (Instruct==RDCR2)
                            next_state <= RDCR2_DATA_OUTPUT;
                        else if (Instruct==RDCR3)
                            next_state <= RDCR3_DATA_OUTPUT;
                        else if (Instruct==RDAR)
                            next_state <= RDAR_ADDR;
                    end
                end

                if (rising_edge_CSNeg_ipd)
                begin
                    if (opcode_cnt==8)
                    begin
                        if (Instruct==CLSR)
                        begin
                            if (SR2V[5])
                            begin
                                if (SR2V[1])  // erase suspend
                                    next_state <= ERSSUS;
                                else
                                    next_state <= STANDBY;
                            end
                        end
                        else if (Instruct==RSTEN)
                            next_state <= SFT_RST_EN;
                    end
                end

                if (rising_edge_PDONE ||
                // operation finished during status read
                (rising_edge_CSNeg_d && PDONE  && !SR2V[5]))
                begin
                    if (SR2V[1])  // erase suspend
                        next_state <= ERSSUS;
                    else
                        next_state <= STANDBY;
                end
            end

            SEC_REG_ERS_ADDR :
            begin
                if (rising_edge_CSNeg_ipd)
                begin
                    if ((!CR2V[0] && addr_cnt == 24) ||
                    (CR2V[0] && addr_cnt == 32))
                        next_state <= SECT_ERS_SEC_REG;
                    else
                    begin
                        if (SR2V[1])
                            next_state <= ERSSUS;
                        else
                            next_state <= STANDBY;
                    end
                end
            end

            SECT_ERS_SEC_REG :
            begin
                if (rising_edge_SCK_D && !CSNeg_ipd)
                begin
                    if (opcode_cnt==8)
                    begin
                        if (Instruct==RDSR1)
                            next_state <= RDSR1_DATA_OUTPUT;
                        else if (Instruct==RDSR2)
                            next_state <= RDSR2_DATA_OUTPUT;
                        else if (Instruct==RDCR1)
                            next_state <= RDCR1_DATA_OUTPUT;
                        else if (Instruct==RDCR2)
                            next_state <= RDCR2_DATA_OUTPUT;
                        else if (Instruct==RDCR3)
                            next_state <= RDCR3_DATA_OUTPUT;
                        else if (Instruct==RDAR)
                            next_state <= RDAR_ADDR;
                    end
                end
                if (rising_edge_CSNeg_ipd)
                begin
                    if (opcode_cnt==8)
                    begin
                        if (Instruct==CLSR)
                        begin
                            if (SR2V[6])
                                next_state = STANDBY;
                        end
                        else if (Instruct==RSTEN)
                            next_state = SFT_RST_EN;
                    end
                end
                if (rising_edge_EDONE ||
                // operation finished during status read
                (rising_edge_CSNeg_d && EDONE  && !SR2V[6]))
                    next_state <= STANDBY;
            end

            PGMSUS :
            begin
                if (rising_edge_SCK_D && !CSNeg_ipd)
                begin
                    if (Instruct==READ || Instruct==READ4)
                        next_state <= RD_ADDR;
                    else if (Instruct==FAST_READ || Instruct==FAST_READ4)
                        next_state <= FAST_RD_ADDR;
                    else if (Instruct==DOR || Instruct==DOR4)
                        next_state <= DUALO_RD_ADDR;
                    else if (Instruct==DIOR || Instruct==DIOR4)
                        next_state <= DUALIO_RD_ADDR;
                    else if (Instruct==QOR || Instruct==QOR4)
                    begin
                        if (QUAD)
                            next_state <= QUADO_RD_ADDR;
                    end
                    else if (Instruct==QIOR || Instruct==QIOR4)
                    begin
                        if (QUAD || QPI)
                            next_state <= QUADIO_RD_ADDR;
                    end
                    else if (Instruct==DDRQIOR || Instruct==DDRQIOR4)
                    begin
                        if (QUAD || QPI)
                        next_state <= DDRQUADIO_RD_ADDR;
                    end
                    else if (Instruct==DLPRD)
                        next_state <= DLPRD_DUMMY;
                    else if (Instruct==IBLRD || Instruct==IBLRD4)
                        next_state <= IBLRD_ADDR;
                    else if (Instruct==SECRR)
                        next_state <= SECRR_ADDR;
                    else if (Instruct==RDID)
                        next_state <= RDID_DATA_OUTPUT;
                    else if (Instruct==RDQID)
                        next_state <= RDQID_DATA_OUTPUT;
                    else if (Instruct==RUID)
                        next_state <= RUID_DUMMY;
                    else if (Instruct==RSFDP)
                        next_state <= RSFDP_ADDR;
                    else if (Instruct==SET_BURST)
                        next_state <= SET_BURST_DATA_INPUT;
                    else if (Instruct==RDSR1)
                        next_state <= RDSR1_DATA_OUTPUT;
                    else if (Instruct==RDSR2)
                        next_state <= RDSR2_DATA_OUTPUT;
                    else if (Instruct==RDCR1)
                        next_state <= RDCR1_DATA_OUTPUT;
                    else if (Instruct==RDCR2)
                        next_state <= RDCR2_DATA_OUTPUT;
                    else if (Instruct==RDCR3)
                        next_state <= RDCR3_DATA_OUTPUT;
                    else if (Instruct==RDAR)
                        next_state <= RDAR_ADDR;
                    else if (Instruct==IBL || Instruct==IBL4)
                    begin
                        if (WPS == 1'b1)
                            next_state <= IBL_LOCK;
                    end
                    else if (Instruct==IBUL || Instruct==IBUL4)
                    begin
                        if (WPS == 1'b1)
                            next_state <= IBL_UNLOCK;
                    end
                end
                if (rising_edge_CSNeg_ipd)
                begin
                    if (opcode_cnt==8)
                    begin
                        if (Instruct==RSTEN)
                            next_state <= SFT_RST_EN;
                        else if (Instruct==EPR)
                            next_state <= PGM;
                    end
                end
            end

            ERSSUS :
            begin
                if (rising_edge_SCK_D && !CSNeg_ipd)
                begin
                    if (Instruct==READ || Instruct==READ4)
                        next_state <= RD_ADDR;
                    else if (Instruct==FAST_READ || Instruct==FAST_READ4)
                        next_state <= FAST_RD_ADDR;
                    else if (Instruct==DOR || Instruct==DOR4)
                        next_state <= DUALO_RD_ADDR;
                    else if (Instruct==DIOR || Instruct==DIOR4)
                        next_state <= DUALIO_RD_ADDR;
                    else if (Instruct==QOR || Instruct==QOR4)
                    begin
                        if (QUAD)
                            next_state <= QUADO_RD_ADDR;
                    end
                    else if (Instruct==QIOR || Instruct==QIOR4)
                    begin
                        if (QUAD || QPI)
                            next_state <= QUADIO_RD_ADDR;
                    end
                    else if (Instruct==DDRQIOR || Instruct==DDRQIOR4)
                    begin
                        if (QUAD || QPI)
                        next_state <= DDRQUADIO_RD_ADDR;
                    end
                    else if (Instruct==DLPRD)
                        next_state <= DLPRD_DUMMY;
                    else if (Instruct==IBLRD || Instruct==IBLRD4)
                        next_state <= IBLRD_ADDR;
                    else if (Instruct==SECRR)
                        next_state <= SECRR_ADDR;
                    else if (Instruct==RDID)
                        next_state <= RDID_DATA_OUTPUT;
                    else if (Instruct==RDQID)
                        next_state <= RDQID_DATA_OUTPUT;
                    else if (Instruct==RUID)
                        next_state <= RUID_DUMMY;
                    else if (Instruct==RSFDP)
                        next_state <= RSFDP_ADDR;
                    else if (Instruct==SET_BURST)
                        next_state <= SET_BURST_DATA_INPUT;
                    else if (Instruct==RDSR1)
                        next_state <= RDSR1_DATA_OUTPUT;
                    else if (Instruct==RDSR2)
                        next_state <= RDSR2_DATA_OUTPUT;
                    else if (Instruct==RDCR1)
                        next_state <= RDCR1_DATA_OUTPUT;
                    else if (Instruct==RDCR2)
                        next_state <= RDCR2_DATA_OUTPUT;
                    else if (Instruct==RDCR3)
                        next_state <= RDCR3_DATA_OUTPUT;
                    else if (Instruct==RDAR)
                        next_state <= RDAR_ADDR;
                    else if (Instruct==IBL || Instruct==IBL4)
                    begin
                        if (WPS == 1'b1)
                            next_state <= IBL_LOCK;
                    end
                    else if (Instruct==IBUL || Instruct==IBUL4)
                    begin
                        if (WPS == 1'b1)
                            next_state <= IBL_UNLOCK;
                    end
                    else if (Instruct==PP || Instruct==PP4)
                    begin
                        if (WEL == 1'b1)
                            next_state <= PGM_ADDR;
                    end
                    else if (Instruct==QPP || Instruct==QPP4)
                    begin
                        if (WEL == 1'b1 && QUAD)
                            next_state <= PGM_ADDR;
                    end
                    else if (Instruct==SECRP)
                    begin
                        if (WEL == 1'b1)
                            next_state <= SEC_REG_PGM_ADDR;
                    end
                end
                if (rising_edge_CSNeg_ipd)
                begin
                    if (opcode_cnt==8)
                    begin
                        if (Instruct==RSTEN)
                            next_state <= SFT_RST_EN;
                        else if (Instruct==EPR)
                        begin
                            if (SECT_ERS_ACT)
                                next_state <= SECT_ERS;
                            else if (HALF_BLOCK_ERS_ACT)
                                next_state <= HALF_BLOCK_ERS;
                            else if (BLOCK_ERS_ACT)
                                next_state <= BLOCK_ERS;
                        end
                    end
                end
            end

            WRR_DATA_INPUT :
            begin
                if (rising_edge_CSNeg_ipd)
                begin
                    if (data_cnt==0 &&
                    byte_cnt>0 && byte_cnt<=4)
                    begin
                        if (!srp1 && (!srp0 || WPNeg_in || QUAD || QPI))
                        begin
                            if (WEL)
                                next_state <= WRR_NV;
                            else if (WREN_V)
                                next_state <= WRR_V;
                        end
                        else
                            next_state <= STANDBY;
                    end
                    else
                        next_state <= STANDBY;
                end
            end

            WRR_NV :
            begin
                if (rising_edge_SCK_D && !CSNeg_ipd)
                begin
                    if (opcode_cnt==8)
                    begin
                        if (Instruct==RDSR1)
                            next_state <= RDSR1_DATA_OUTPUT;
                        else if (Instruct==RDSR2)
                            next_state <= RDSR2_DATA_OUTPUT;
                        else if (Instruct==RDCR1)
                            next_state <= RDCR1_DATA_OUTPUT;
                        else if (Instruct==RDCR2)
                            next_state <= RDCR2_DATA_OUTPUT;
                        else if (Instruct==RDCR3)
                            next_state <= RDCR3_DATA_OUTPUT;
                        else if (Instruct==RDAR)
                            next_state <= RDAR_ADDR;
                    end
                end

                if (rising_edge_CSNeg_ipd)
                begin
                    if (opcode_cnt==8)
                    begin
                        if (Instruct==CLSR)
                        begin
                            if (SR2V[5])
                                next_state <= STANDBY;
                        end
                    end
                end

                if (rising_edge_WDONE ||
                (rising_edge_CSNeg_d && WDONE  && !SR2V[5]))
                    next_state <= STANDBY;
            end

            WRR_V :
            begin
                if (rising_edge_WDONE)
                    next_state <= STANDBY;
            end

            WRAR_ADDR :
            begin
                if (rising_edge_SCK_D && !CSNeg_ipd)
                begin
                    if ((!CR2V[0] && addr_cnt==24) ||
                    (CR2V[0] && addr_cnt==32))
                        next_state <= WRAR_DATA_INPUT;
                end
                if (rising_edge_CSNeg_ipd)
                    next_state <= STANDBY;
            end

            WRAR_DATA_INPUT :
            begin
                if (rising_edge_CSNeg_ipd)
                begin
                    if (data_cnt==8)
                    begin
                        if ((Address_wrar==24'h0) || (Address_wrar==24'h2) ||
                        (Address_wrar==24'h3) || (Address_wrar==24'h4) ||
                        (Address_wrar==24'h5))
                            if (!srp1 && (!srp0 || WPNeg_in || QUAD || QPI))
                                next_state <= WRAR_NV;
                            else
                                next_state <= STANDBY;

                        if ((Address_wrar>=24'h20) && (Address_wrar<=24'h27))
                        begin
                            if (IRP[2])
                                next_state <= WRAR_NV;
                            else
                                next_state <= STANDBY;
                        end
                        if ((Address_wrar==24'h30) || (Address_wrar==24'h31))
                            next_state <= WRAR_NV;

                        if ((Address_wrar==24'h39) ||
                        (Address_wrar==24'h3A) || (Address_wrar==24'h3B))
                        begin
                            if (NVLOCK)
                                next_state <= WRAR_NV;
                            else
                                next_state <= STANDBY;
                        end

                        if ((Address_wrar==24'h800000)
                        || (Address_wrar==24'h800002) || (Address_wrar==24'h800003)
                        || (Address_wrar==24'h800005))
                        begin
                            if (!srp1 && (!srp0 || WPNeg_in || QUAD || QPI))
                                next_state <= WRAR_V;
                            else
                                next_state <= STANDBY;
                        end
                        if (Address_wrar==24'h800004)
                            next_state <= WRAR_V;
                    end
                    else
                        next_state <= STANDBY;
                end
            end

            WRAR_NV :
            begin
                if (rising_edge_SCK_D && !CSNeg_ipd)
                begin
                    if (opcode_cnt==8)
                    begin
                        if (Instruct==RDSR1)
                            next_state <= RDSR1_DATA_OUTPUT;
                        else if (Instruct==RDSR2)
                            next_state <= RDSR2_DATA_OUTPUT;
                        else if (Instruct==RDCR1)
                            next_state <= RDCR1_DATA_OUTPUT;
                        else if (Instruct==RDCR2)
                            next_state <= RDCR2_DATA_OUTPUT;
                        else if (Instruct==RDCR3)
                            next_state <= RDCR3_DATA_OUTPUT;
                        else if (Instruct==RDAR)
                            next_state <= RDAR_ADDR;
                    end
                end

                if (rising_edge_CSNeg_ipd)
                begin
                    if (opcode_cnt==8)
                    begin
                        if (Instruct==CLSR)
                        begin
                            if (SR2V[5])
                                next_state <= STANDBY;
                        end
                        else if (Instruct==RSTEN)
                        begin
                            if (Address!=24'h0 && Address!=24'h2 &&
                            Address!=24'h03 && Address!=24'h04)
                                next_state = SFT_RST_EN;
                        end
                    end
                end

                if (rising_edge_WDONE ||
                (rising_edge_CSNeg_d && WDONE && !SR2V[5]))
                    next_state <= STANDBY;
            end

            WRAR_V :
            begin
                if (rising_edge_WDONE)
                    next_state <= STANDBY;
            end

            IRP_PGM_DATA_INPUT :
            begin
                if (rising_edge_CSNeg_ipd)
                begin
                  if (data_cnt==0 && byte_cnt==2)
                      next_state <= IRP_PGM;
                  else
                      next_state <= STANDBY;
                end
            end

            IRP_PGM :
            begin
                if (rising_edge_SCK_D && !CSNeg_ipd)
                begin
                    if (opcode_cnt==8)
                    begin
                        if (Instruct==RDSR1)
                            next_state <= RDSR1_DATA_OUTPUT;
                        else if (Instruct==RDSR2)
                            next_state <= RDSR2_DATA_OUTPUT;
                        else if (Instruct==RDCR1)
                            next_state <= RDCR1_DATA_OUTPUT;
                        else if (Instruct==RDCR2)
                            next_state <= RDCR2_DATA_OUTPUT;
                        else if (Instruct==RDCR3)
                            next_state <= RDCR3_DATA_OUTPUT;
                        else if (Instruct==RDAR)
                            next_state <= RDAR_ADDR;
                    end
                end

                if (rising_edge_CSNeg_ipd)
                begin
                    if (opcode_cnt==8)
                    begin
                        if (Instruct==CLSR)
                        begin
                            if (SR2V[5])
                                next_state = STANDBY;
                        end
                        else if (Instruct==RSTEN)
                            next_state = SFT_RST_EN;
                    end
                end
                if (rising_edge_PDONE ||
                (rising_edge_CSNeg_d && PDONE && !SR2V[5]))
                    next_state <= STANDBY;
            end

            PGM_NV_DLR_DATA :
            begin
                if (rising_edge_CSNeg_ipd)
                begin
                  if (data_cnt==8 )
                      next_state <= PGM_NV_DLR;
                  else
                      next_state <= STANDBY;
                end
            end

            PGM_NV_DLR :
            begin
                if (rising_edge_SCK_D && !CSNeg_ipd)
                begin
                    if (opcode_cnt==8)
                    begin
                        if (Instruct==RDSR1)
                            next_state <= RDSR1_DATA_OUTPUT;
                        else if (Instruct==RDSR2)
                            next_state <= RDSR2_DATA_OUTPUT;
                        else if (Instruct==RDCR1)
                            next_state <= RDCR1_DATA_OUTPUT;
                        else if (Instruct==RDCR2)
                            next_state <= RDCR2_DATA_OUTPUT;
                        else if (Instruct==RDCR3)
                            next_state <= RDCR3_DATA_OUTPUT;
                        else if (Instruct==RDAR)
                            next_state <= RDAR_ADDR;
                    end
                end

                if (rising_edge_CSNeg_ipd)
                begin
                    if (opcode_cnt==8)
                    begin
                        if (Instruct==CLSR)
                        begin
                            if (SR2V[5])
                                next_state <= STANDBY;
                        end
                        else if (Instruct==RSTEN)
                            next_state = SFT_RST_EN;
                    end
                end

                if (rising_edge_PDONE ||
                (rising_edge_CSNeg_d && PDONE  && !SR2V[5]))
                    next_state <= STANDBY;
            end

            DLRV_WRITE_DATA :
            begin
                if (rising_edge_CSNeg_ipd)
                    next_state <= STANDBY;
            end

            SET_PNTR_PROT_ADDR :
            begin
                if (rising_edge_CSNeg_ipd)
                begin
                    if ((Instruct == SPRP4 && addr_cnt == 32) ||
                    (Instruct == SPRP && ((!CR2V[0] && addr_cnt == 24) ||
                    (CR2V[0] && addr_cnt == 32))))
                        next_state <= SET_PNTR_PROT;
                    else
                        next_state <= STANDBY;
                end
            end

            SET_PNTR_PROT :
            begin
                if (rising_edge_SCK_D && !CSNeg_ipd)
                begin
                    if (opcode_cnt==8)
                    begin
                        if (Instruct==RDSR1)
                            next_state <= RDSR1_DATA_OUTPUT;
                        else if (Instruct==RDSR2)
                            next_state <= RDSR2_DATA_OUTPUT;
                        else if (Instruct==RDCR1)
                            next_state <= RDCR1_DATA_OUTPUT;
                        else if (Instruct==RDCR2)
                            next_state <= RDCR2_DATA_OUTPUT;
                        else if (Instruct==RDCR3)
                            next_state <= RDCR3_DATA_OUTPUT;
                        else if (Instruct==RDAR)
                            next_state <= RDAR_ADDR;
                    end
                end

                if (rising_edge_CSNeg_ipd)
                begin
                    if (opcode_cnt==8)
                    begin
                        if (Instruct==CLSR)
                        begin
                            if ((SR2V[5]) || (SR2V[6]))
                                next_state <= STANDBY;
                        end
                        else if (Instruct==RSTEN)
                            next_state = SFT_RST_EN;
                    end
                end

                if (rising_edge_WDONE ||
                (rising_edge_CSNeg_d && WDONE && !SR2V[5]))
                    next_state <= STANDBY;
            end

            PASSP_DATA_INPUT :
            begin
                if (rising_edge_CSNeg_ipd)
                begin
                  if (data_cnt==0 && byte_cnt==8 )
                      next_state <= PASS_PGM;
                  else
                      next_state <= STANDBY;
                end
            end

            PASS_PGM :
            begin
                if (rising_edge_SCK_D && !CSNeg_ipd)
                begin
                    if (opcode_cnt==8)
                    begin
                        if (Instruct==RDSR1)
                            next_state <= RDSR1_DATA_OUTPUT;
                        else if (Instruct==RDSR2)
                            next_state <= RDSR2_DATA_OUTPUT;
                        else if (Instruct==RDCR1)
                            next_state <= RDCR1_DATA_OUTPUT;
                        else if (Instruct==RDCR2)
                            next_state <= RDCR2_DATA_OUTPUT;
                        else if (Instruct==RDCR3)
                            next_state <= RDCR3_DATA_OUTPUT;
                        else if (Instruct==RDAR)
                            next_state <= RDAR_ADDR;
                    end
                end

                if (rising_edge_CSNeg_ipd)
                begin
                    if (opcode_cnt==8)
                    begin
                        if (Instruct==CLSR)
                        begin
                            if (SR2V[5])
                                next_state <= STANDBY;
                        end
                        else if (Instruct==RSTEN)
                            next_state = SFT_RST_EN;
                    end
                end

                if (rising_edge_PDONE ||
                (rising_edge_CSNeg_d && PDONE && !SR2V[5]))
                    next_state <= STANDBY;
            end

            PASSU_DATA_INPUT :
            begin
                if (rising_edge_CSNeg_ipd)
                begin
                  if (data_cnt==0 && byte_cnt==8 )
                      next_state <= PASS_PGM;
                  else
                      next_state <= STANDBY;
                end
            end
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
