bradleyeckert/chad/verilog/testbench/spif_tb.v

// spif testbench

`timescale 1ns / 1ns

module spif_tb();

    reg	 clk = 1;
    reg	 rst_n = 0;

    // Processor interface (J1, chad, etc)
    reg			 io_rd = 0;	// I/O read strobe: get io_din	  i
    reg			 io_wr = 0;	// I/O write strobe: register din i
    reg			 mem_rd = 0;	// Data memory read enable	  i
    reg			 mem_wr = 0;	// Data memory write enable	  i
    reg	 [14:0]		 mem_addr = 0;	// Data memory address		  i
    reg	 [17:0]		 din = 0;	// Data memory & I/O in (from N)  i
    wire [17:0]		 mem_dout;	// Data memory out		  o
    wire [17:0]		 io_dout;	// I/O data out			  o
    reg	 [12:0]		 code_addr = 0;	// Code memory address		  i
    wire [15:0]		 insn;		// Code memory data		  o
    wire		 p_hold;	// Processor hold		  o
    wire		 p_reset;	// Processor reset		  o
    //	UART interface
    wire		 u_ready;	// Ready for next byte to send	  i
    wire		 u_wr;		// UART transmit strobe		  o
    wire [7:0]		 u_din;		// UART transmit data		  o
    wire		 u_full;	// UART has received a byte	  i
    wire		 u_rd;		// UART received strobe		  o
    wire [7:0]		 u_dout;	// UART received data		  i
    wire [15:0]          u_rate = 32;   // UART baud rate divisor         o
    //	Flash Memory interface
    wire		 f_ready;	// Ready for next byte to send	  i
    wire		 f_wr;		// Flash transmit strobe	  o
    wire [7:0]		 f_dout;	// Flash transmit data		  o
    wire [2:0]		 f_format;	// Flash format			  o
    wire [3:0]		 f_rate;	// Flash configuration setup	  o
    wire [7:0]		 f_din;		// Flash received data		  i

    reg uart_rst_n = 0;  // release UART reset later than global reset

    wire [55:0]          key = 0;       // demo key
    wire [23:0]          sernum = 18;   // serial number or HW revision
    wire [47:0]  isppass = 48'hA55A11223344;  // ISP password

    wire [9:0]           data_a;        // Data RAM read/write address
    wire [17:0]          data_din;      // Data RAM write data
    wire                 data_wr;       // Data RAM write enable
    wire                 data_rd;       // Data RAM read enable

    spram #(10, 18) data_ram (
      .clk      (clk      ),
      .addr     (data_a   ),
      .din      (data_din ),
      .dout     (mem_dout ),
      .we       (data_wr  ),
      .re       (data_rd  )
    );

    wire [9:0]           code_a;        // Code RAM read/write address
    wire [15:0]          code_din;      // Code RAM write data
    wire                 code_wr;       // Code RAM write enable
    wire                 code_rd;       // Code RAM read enable

    spram #(10, 16) code_ram (
      .clk      (clk      ),
      .addr     (code_a   ),
      .din      (code_din ),
      .dout     (insn     ),
      .we       (code_wr  ),
      .re       (code_rd  )
    );

// Wishbone master
  wire [14:0] adr_o;
  wire [31:0] dat_o, dat_i;
  wire we_o, stb_o, ack_i;

// For testing, we loop back stb_o to ack_i.

  reg [31:0] wbreg;
  reg stb_od;
  always @(posedge clk or negedge rst_n) begin
    if (!rst_n)
      wbreg <= 'b0;
    else begin
      if ((stb_o) && (we_o))
        wbreg <= dat_o;
      stb_od <= stb_o; // delayed stb
    end
  end

  assign dat_i = wbreg;
  assign ack_i = stb_od;


    // 100 MHz clock
    always #5 clk = ~clk;

    // spif is the SPI flash controller
    spif #(10, 18, 10, 0, 16, 7, 0)
    u0 (
	.clk(clk),
	.arstn(rst_n),
	.io_rd	  (io_rd    ),
	.io_wr	  (io_wr    ),
	.mem_rd	  (mem_rd   ),
	.mem_wr	  (mem_wr   ),
	.mem_addr (mem_addr ),
	.din	  (din	    ),
	.io_dout  (io_dout  ),
	.code_addr(code_addr),
	.p_hold	  (p_hold   ),
	.p_reset  (p_reset  ),
        .data_a   (data_a   ),
        .data_din (data_din ),
        .data_wr  (data_wr  ),
        .data_rd  (data_rd  ),
        .code_a   (code_a   ),
        .code_din (code_din ),
        .code_wr  (code_wr  ),
        .code_rd  (code_rd  ),
        .key      (key      ),
        .sernum   (sernum   ),
        .isppass  (isppass  ),
        .ISPenable (1'b1    ),
        .u_ready  (u_ready  ),
        .u_wr     (u_wr     ),
        .u_dout   (u_dout   ),
        .u_full   (u_full   ),
        .u_rd     (u_rd     ),
        .u_din    (u_din    ),
        .f_ready  (f_ready  ),
        .f_wr     (f_wr     ),
        .f_dout   (f_dout   ),
        .f_format (f_format ),
        .f_rate   (f_rate   ),
        .f_din    (f_din    ),
        .adr_o    (adr_o    ),
        .dat_o    (dat_o    ),
        .dat_i    (dat_i    ),
        .we_o     (we_o     ),
        .stb_o    (stb_o    ),
        .ack_i    (ack_i    ),
        .cyclev   (cyclev   ),
        .urxirq   (urxirq   ),
        .utxirq   (utxirq   ),
        .badboot  (badboot  )
    );

//// flash simulator reads bytes from a file
//    flashsim #("fdata.bin") u1 (
//	.clk(clk),
//	.arstn(rst_n),
//	.ready	  (f_ready  ),
//	.wr	  (f_wr	    ),
//	.din	  (f_dout   ),
//	.format	  (f_format ),
//	.prescale (f_rate   ),
//	.dout	  (f_din    )
//    );

// SPI flash connects through sflash.v

  wire          sclk;
  wire          cs_n;
  wire  [3:0]   qdi;
  wire  [3:0]   qdo;
  wire  [3:0]   qoe;            // output enable for qdo
  wire  [3:0]   qd;             // quad data bus

  sflash SPIflash (
    .clk      (clk      ),
    .arstn    (rst_n    ),
    .ready    (f_ready  ),
    .wr       (f_wr     ),
    .din      (f_dout   ),
    .format   (f_format ),
    .prescale (f_rate   ),
    .dout     (f_din    ),
    .sclk     (sclk     ),
    .cs_n     (cs_n     ),
    .qdi      (qdi      ),
    .qdo      (qdo      ),
    .oe       (qoe      )
  );

  assign qdi = qd;
  assign qd[0] = (qoe[0]) ? qdo[0] : 1'bZ;
  assign qd[1] = (qoe[1]) ? qdo[1] : 1'bZ;
  assign qd[2] = (qoe[2]) ? qdo[2] : 1'bZ;
  assign qd[3] = (qoe[3]) ? qdo[3] : 1'bZ;
  pullup(qd[3]);                // pullup resistors on wpn and holdn
  pullup(qd[2]);

  s25fl064l #(
    .mem_file_name ("flash.txt"),
    .secr_file_name ("none")
  ) memchip (
    .SCK          (sclk ),
    .SO           (qd[1]),
    .CSNeg        (cs_n ),
    .IO3_RESETNeg (qd[3]),
    .WPNeg        (qd[2]),
    .SI           (qd[0]),
    .RESETNeg     (rst_n)
  );

    // UART simulator reads bytes from a file
    uartsim #("udata.bin") u2 (
	.clk      (clk),
	.arstn    (~p_reset),
	.ready	  (u_ready ),
	.wr	  (u_wr	   ),
	.din	  (u_dout  ),
	.full	  (u_full  ),
	.rd	  (u_rd	   ),
	.dout	  (u_din   ),
	.bitperiod(u_rate  )
    );

    // Write to i/o space
    task IO_WRITE;
      input [17:0] data;
      input  [3:0] addr;
      begin
        @(posedge clk);  io_wr <= 1'b1;  din <= data;  mem_addr <= addr;
        @(posedge clk);  io_wr <= 1'b0;
      end
    endtask // IO_WRITE

    // poll the busy flag until it's not busy
    task WAIT;
      input [2:0] addr;
      integer busy;
      begin
        busy = 1;
        while (busy) begin
          @(posedge clk);  io_rd <= 1'b1;  mem_addr <= addr;
          @(posedge clk);  io_rd <= 1'b0;
          @(posedge clk);  io_rd <= 1'b0;  busy <= io_dout[0];
        end
      end
    endtask // WAIT

    initial
    begin
	$display("Bootup started at %0t", $time);
	#7 rst_n = 1;
        @(negedge p_reset);     // wait for boot to finish
	$display("Bootup finished at %0t", $time);
        repeat(10) @(posedge clk);
        IO_WRITE(65, 0);        // send a byte to the UART
//        IO_WRITE(18'h2084, 6);  // 3-byte read setup
//        IO_WRITE(18'h2000, 11); // flash read
//        WAIT(5);
//	$display("Flash read finished at %0t", $time);

        repeat (20) @(posedge clk);
        uart_rst_n <= 1;

//        IO_WRITE(4, 4);      WAIT(4);  // 5-byte sequence to flash
//        IO_WRITE(8'h81, 4);  WAIT(4);  // start SPI sequence, single rate
//        IO_WRITE(8'h0B, 4);  WAIT(4);
//        IO_WRITE(8'h00, 4);  WAIT(4);
//        IO_WRITE(8'h00, 4);  WAIT(4);
//        IO_WRITE(8'h80, 4);  WAIT(4);
//        IO_WRITE(8'h00, 4);  WAIT(4);
//        IO_WRITE(8'h11, 3);   // start the flash interpreter
//        WAIT(5);              // wait until interpreter is finished


//	$display("status: %t done reset", $time);
//
//	@(posedge clk);
//
//	$display("\n\nstatus: %t Testbench done", $time);
//	$finish;
    end

endmodule
