bradleyeckert/chad/src/iomap.h

//==============================================================================
// iomap.h
//==============================================================================
#ifndef __IOMAP_H__
#define __IOMAP_H__

uint32_t readIOmap (uint32_t addr);
int writeIOmap (uint32_t addr, uint32_t x);
void killHostIO(void);

// Load memory spaces from the boot stream
void FlashMemBoot(int startaddr);

#define BAD_IOADDR  -70
#define BAD_HOSTAPI -76

extern uint64_t ChadBootKey;

// Function prototypes for specialzed peripherals

#ifdef HAS_LCDMODULE
#include "../guisim/TFTsim.h"
#endif

#ifdef HAS_LEDSTRIP
void LEDstripWrite(uint16_t sr);
#endif

#endif // __IOMAP_H__
