bradleyeckert/chad/src/gecko.h

//==============================================================================
// gecko.h
//==============================================================================
#ifndef __GECKO_H__
#define __GECKO_H__
#include <stdint.h>

void GeckoState(void);
void GeckoLoad(uint64_t key);
uint8_t GeckoByte(void);

#endif // __GECKO_H__
