bradleyeckert/chad/(commit log)

2020-08-30 added SPI flash
2020-09-03 fixed marker and empty
    [chad.c, chaddefs.h, config.h, iomap.c]
2020-09-08 fixed begin while repeat
    [chad.c, chaddefs.h, config.h, errors.c, iomap.c]
2020-09-10 cleaned up tracing, added frame stack
2020-10-05 Implemented Verilog-based MCU to simplify handling of the SPI flash. Removed carry-in from the adder because it's slow.
2020-10-13 Added SPI flash and boot file to MCU testbench
2020-10-14 Fixed MCU to boot and execute "myapp.txt"
    [chad.c, chad.v, mcu.v, mcu_tb.v, spif.v]
2020-10-17 Added encryption to SPI flash for code security
2020-10-28 Added SPI flash "DRM" (key.c) and tested it in Verilog simulation.
2020-10-29 Buffered UART output
2020-11-11 Added interrupts to the processor
2020-11-12 Added priority encoder for interrupts
2020-11-12 Tweaked priority encoder
2020-11-12 Added UART interrupts
2020-11-18 Boots and runs in Verilog and C with encrypted SPI flash
2020-11-19 Fixed zero length string parsing
    [chad.c, chaddefs.h, errors.c]
2020-11-22 Added interrupts to simulator
2020-11-23 Added escape sequence to UART output stream
2020-12-09 Improved SPI flash read
2020-12-11 Moved more SPI flash access into hardware
2020-12-14 Fixed ISP, added Brevia2 board
    [chad.c, isp.c, mcu.v, mcu_arty.xdc, mcu_top.v]
2021-08-02 Backed out of wordlist changes but kept some minor fixes
    [chad.c]
2021-08-22 Fixed verilog for the trap instruction
    [chad.v, mcu.v, spif.v]
2021-08-22 Fixed Verilog for trap instruction
    [ASIC.xlsx]
2021-08-22 Added flash-load retry on read error
    [iomap.c]
2021-09-14 Applet support and SPIF changes
    [ASIC.xlsx]
