bradleyeckert/chad/(notices)

Notices in the files:
verilog/testbench/s25fl064l.v:
This program is free software; you can redistribute it and/or modify
it under the terms of the GNU General Public License version 2 as
published by the Free Software Foundation.
utility/isp/rs232.c:
it under the terms of the GNU General Public License as published by
the Free Software Foundation, either version 3 of the License.
